TeaTimeIroh/AutomatedChessboard/docs/images/board_surface-detail_20260425_212329.jpg

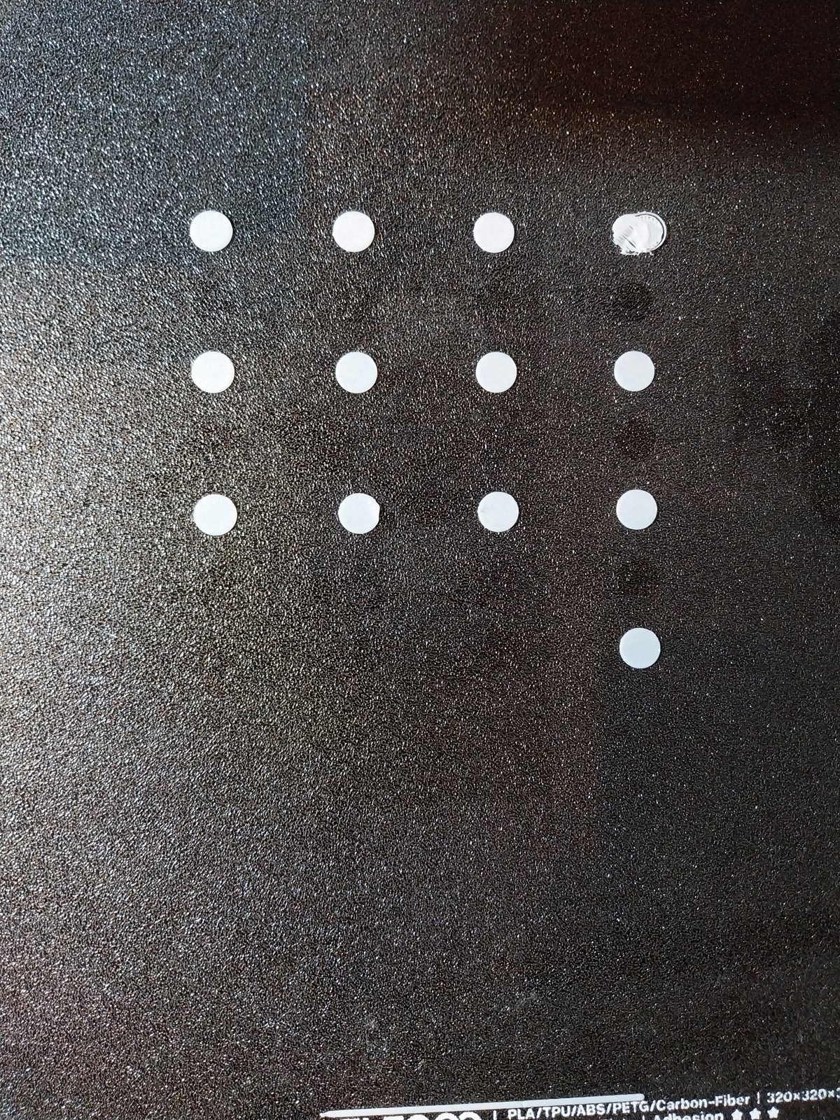
docs/images/board_surface-detail_20260425_212329.jpg
