TeaTimeIroh/AutomatedChessboard/docs/images/board_surface_20260415_192006.jpg

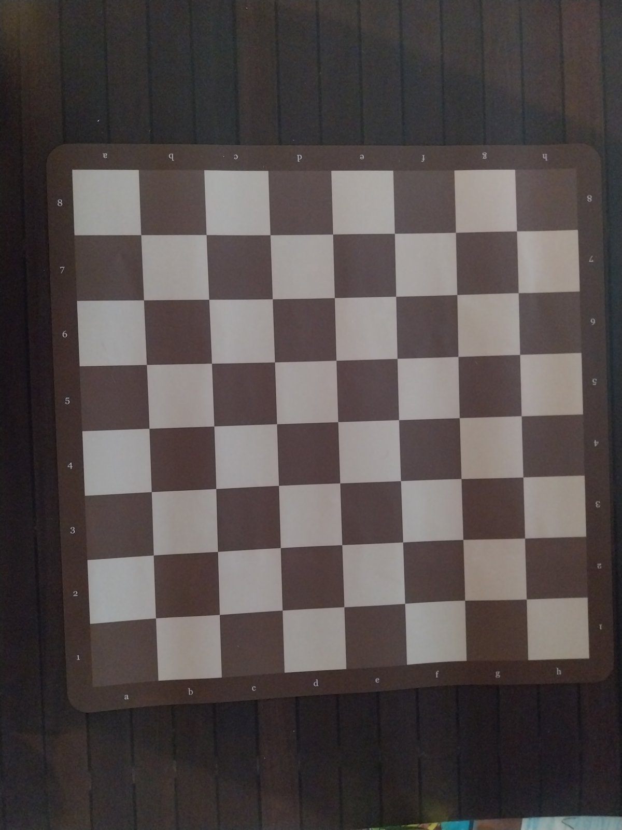
docs/images/board_surface_20260415_192006.jpg
