TeaTimeIroh/AutomatedChessboard/docs/images/corexy_stepper-mount-detail_20260308_001144.jpg

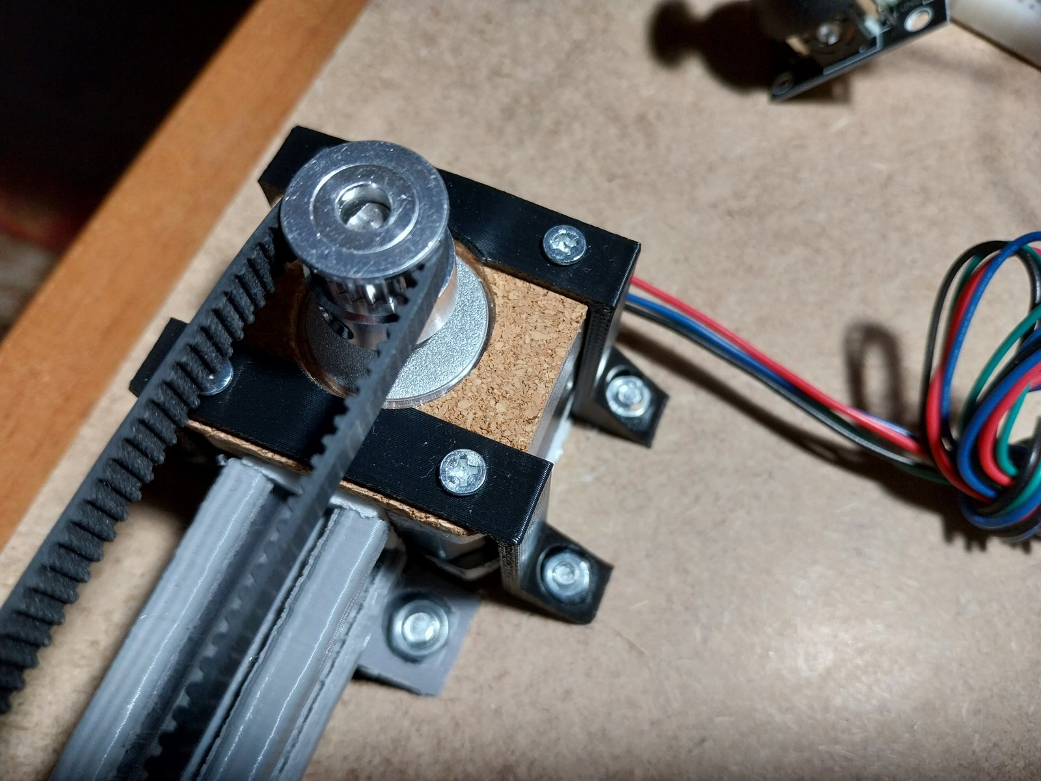
docs/images/corexy_stepper-mount-detail_20260308_001144.jpg
