TeaTimeIroh/AutomatedChessboard/docs/images/final_gantry-underside_20260501_181351.jpg

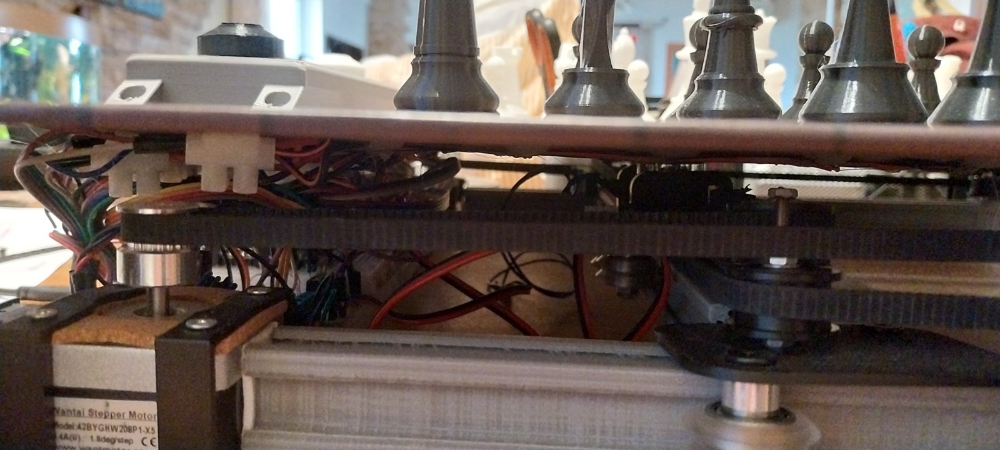
docs/images/final_gantry-underside_20260501_181351.jpg
