TeaTimeIroh/AutomatedChessboard/docs/images/final_ui-lcd-and-buttons_20260430_023114.jpg

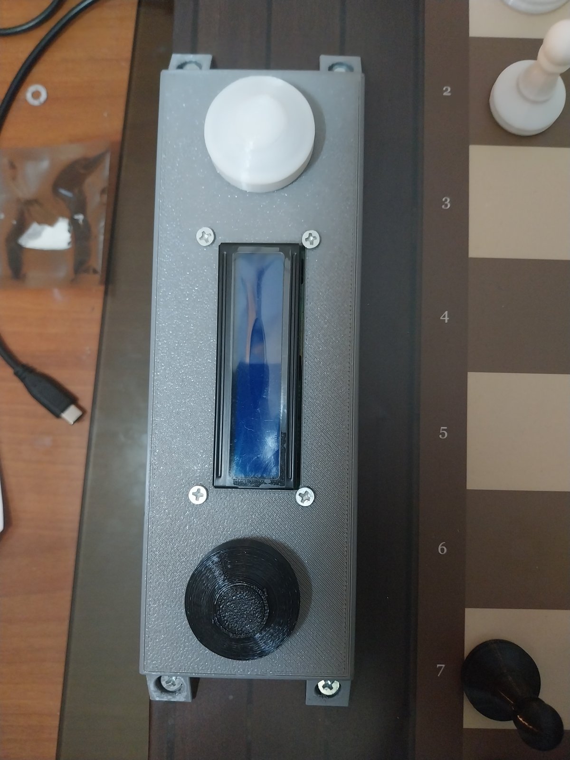
docs/images/final_ui-lcd-and-buttons_20260430_023114.jpg
