TeaTimeIroh/AutomatedChessboard/docs/images/reed-grid_copper-tape_20260313_010757.jpg

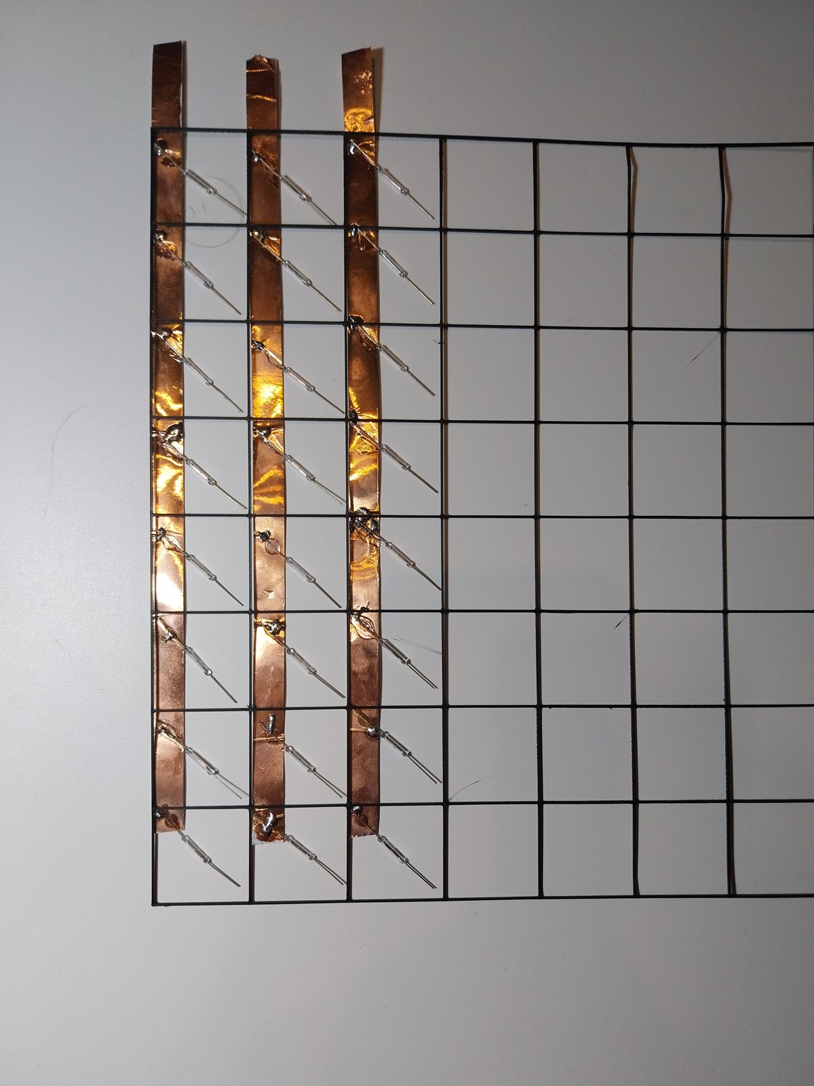
docs/images/reed-grid_copper-tape_20260313_010757.jpg
