TeaTimeIroh/AutomatedChessboard/docs/images/reed-grid_copper-tape_20260314_181305.jpg

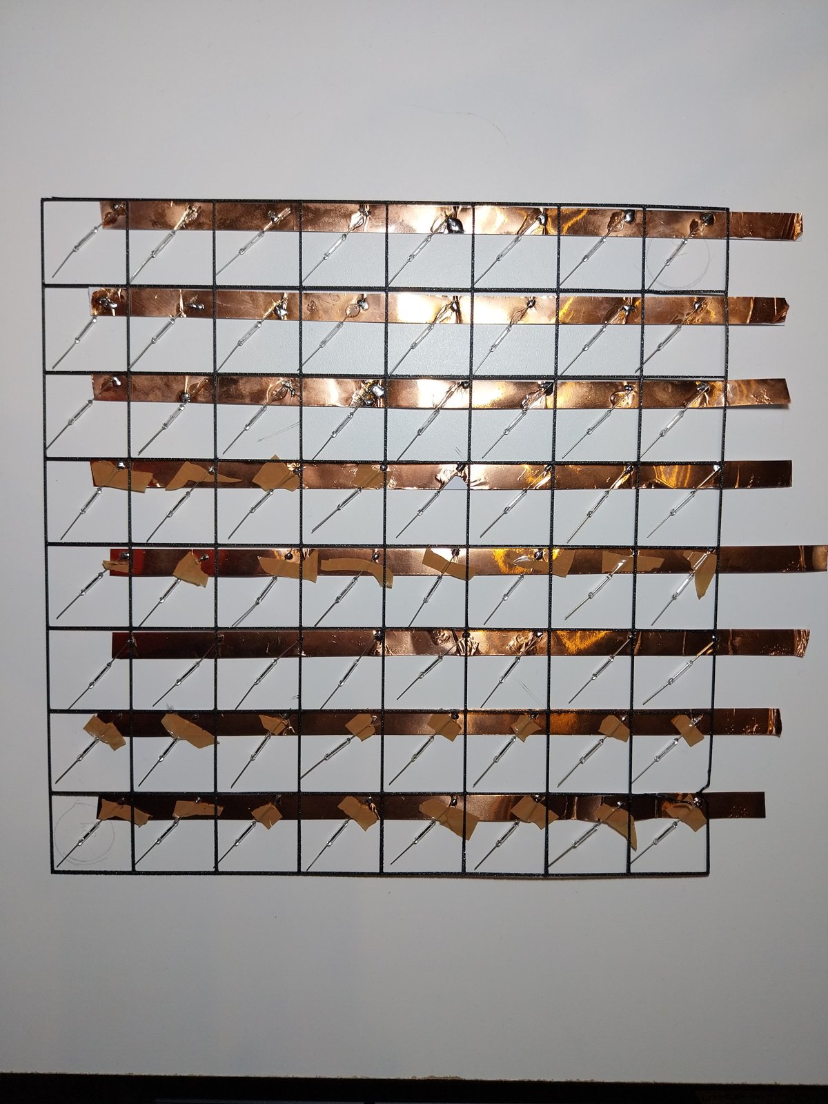
docs/images/reed-grid_copper-tape_20260314_181305.jpg
