TeaTimeIroh/AutomatedChessboard/Flowcharts/detectMove().png

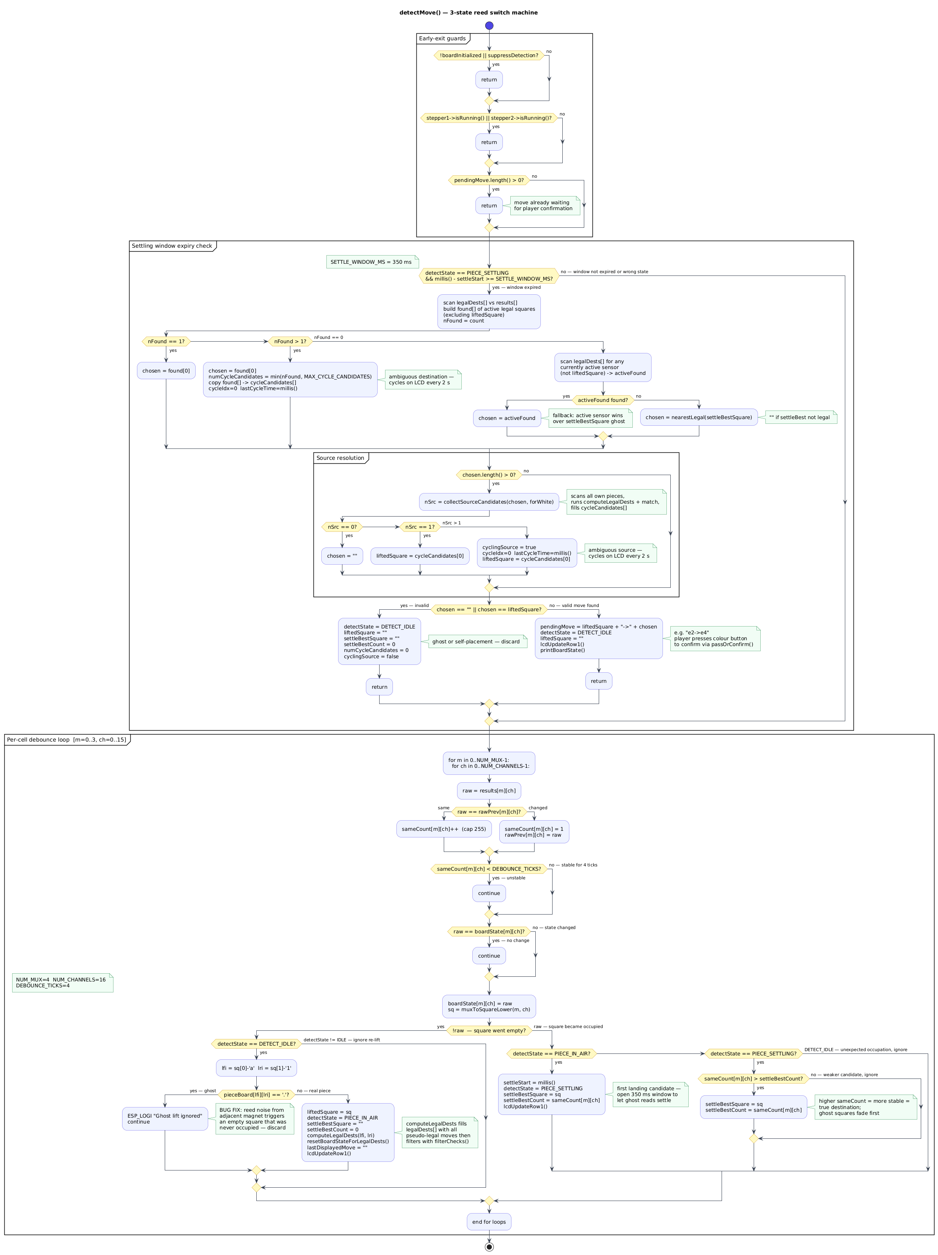
Flowcharts/detectMove().png
