TeaTimeIroh/AutomatedChessboard/Flowcharts/loop().png

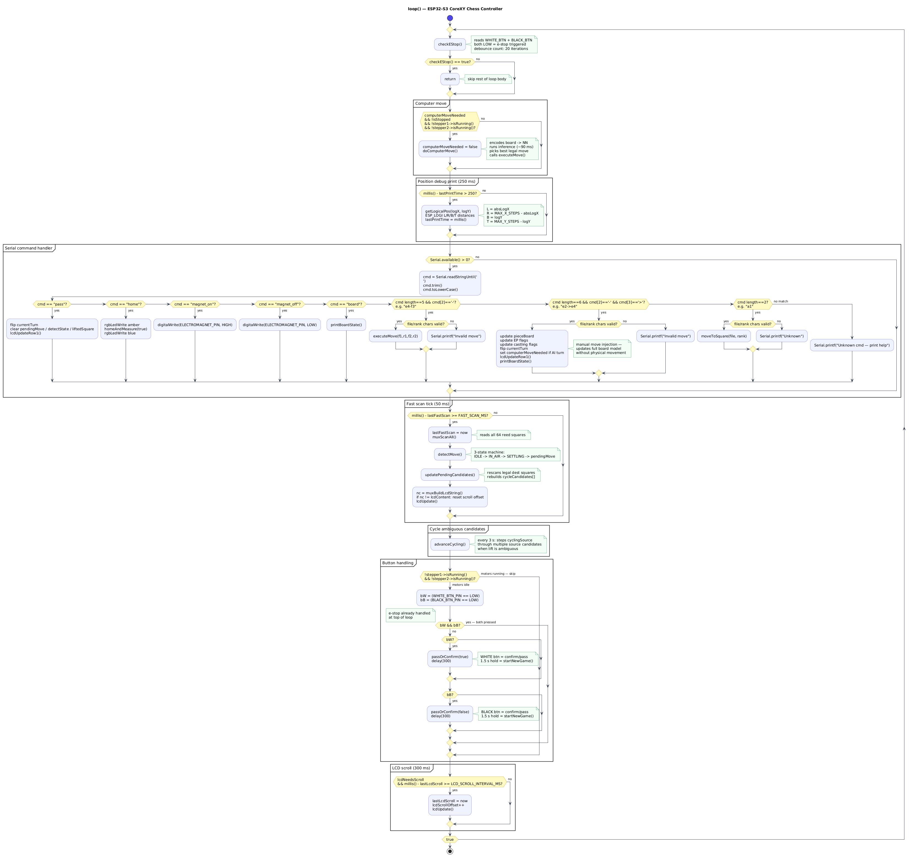
Flowcharts/loop().png
