TeaTimeIroh/AutomatedChessboard/Images/20260319_215423.jpg

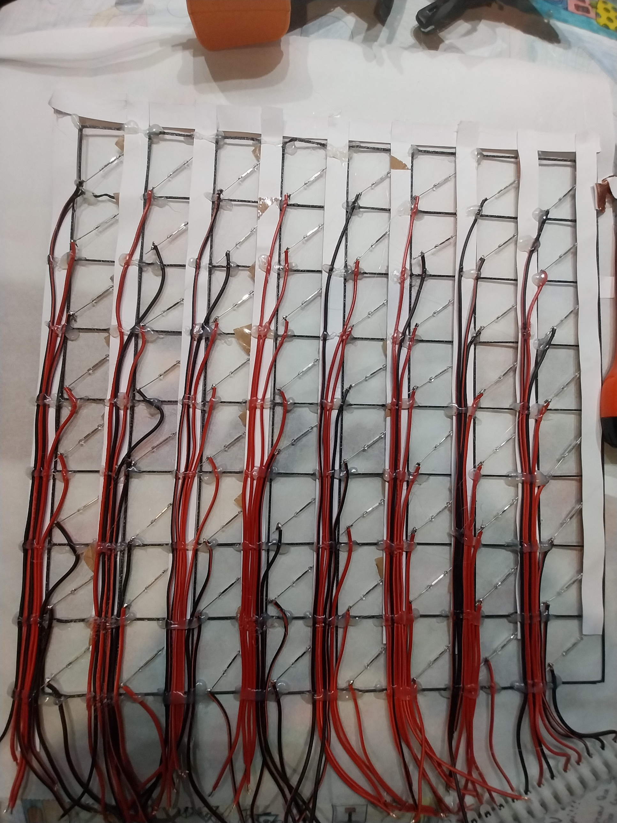
Images/20260319_215423.jpg
