TeaTimeIroh/AutomatedChessboard/Images/20260404_231630.jpg

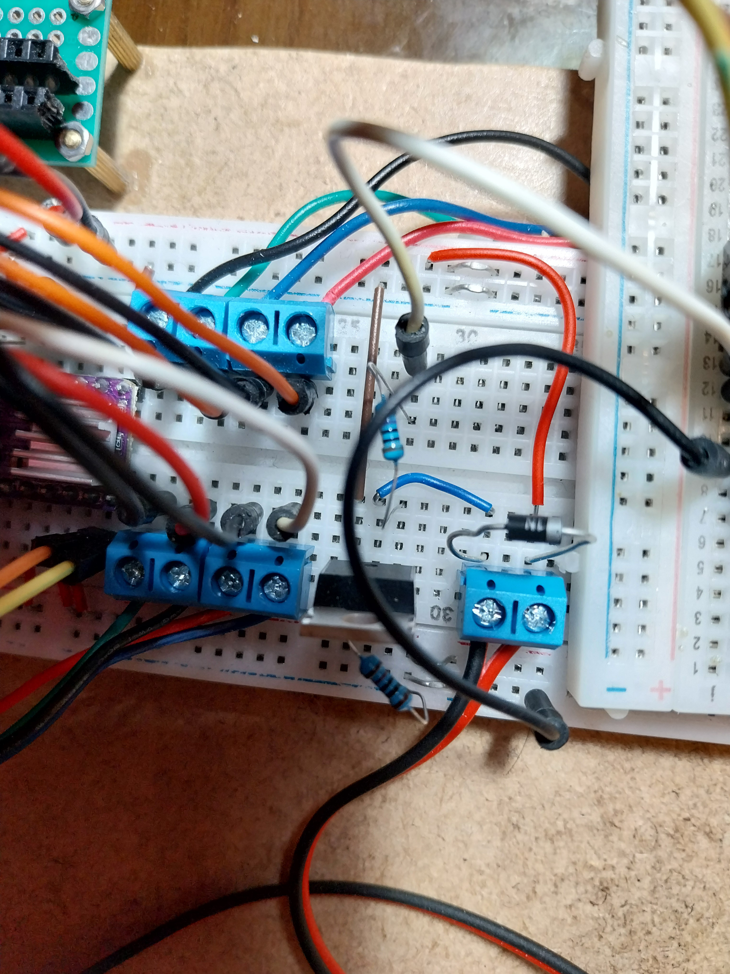
Images/20260404_231630.jpg
