TeaTimeIroh/AutomatedChessboard/3D Models/VbeamFullLengthBase.stl

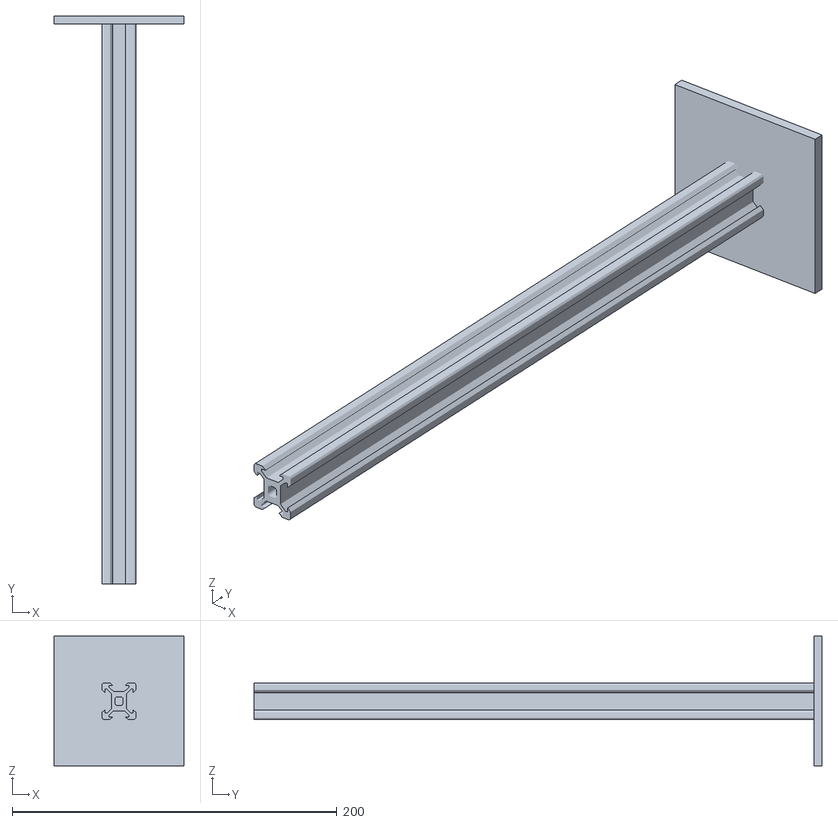
[picture p93: CAD file, 2026-05-11]
3D Models/VbeamFullLengthBase.stl
80.0 x 350.0 x 80.0
