TeaTimeIroh/AutomatedChessboard/3D Models/ButtonLarge.stl

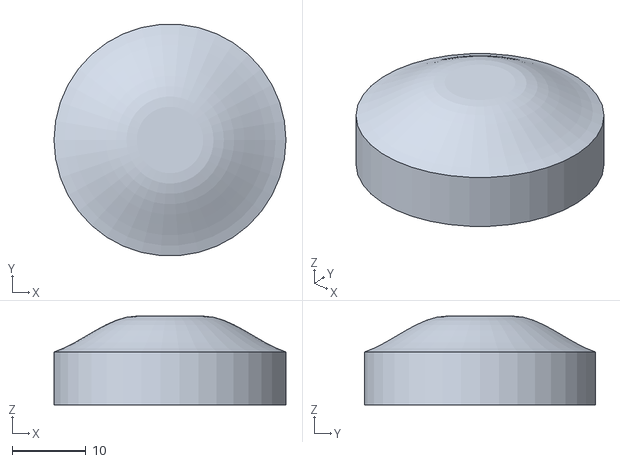
[picture p94: CAD file, 2026-05-11]
3D Models/ButtonLarge.stl
31.4 x 31.3 x 12.0
