TeaTimeIroh/AutomatedChessboard/cad/parts/LittleCircleExtension.stl

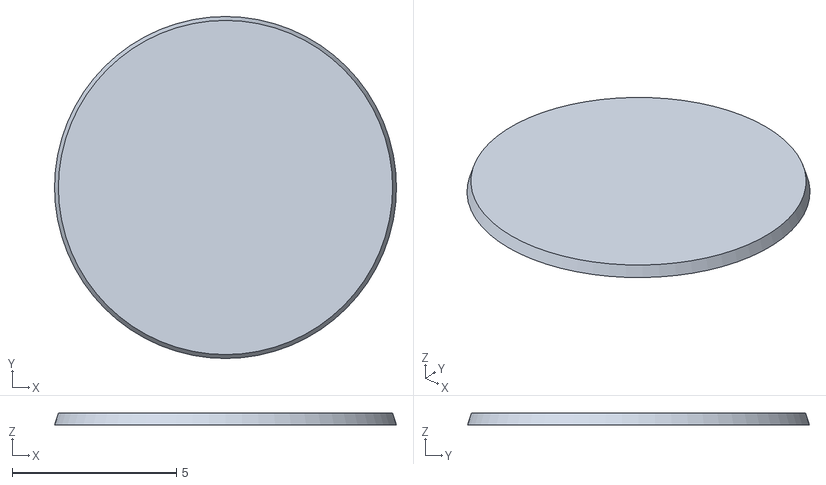
[picture p95: CAD file, 2026-05-11]
cad/parts/LittleCircleExtension.stl
10.4 x 10.4 x 0.37
