TeaTimeIroh/AutomatedChessboard/cad/pieces/Knight.stl

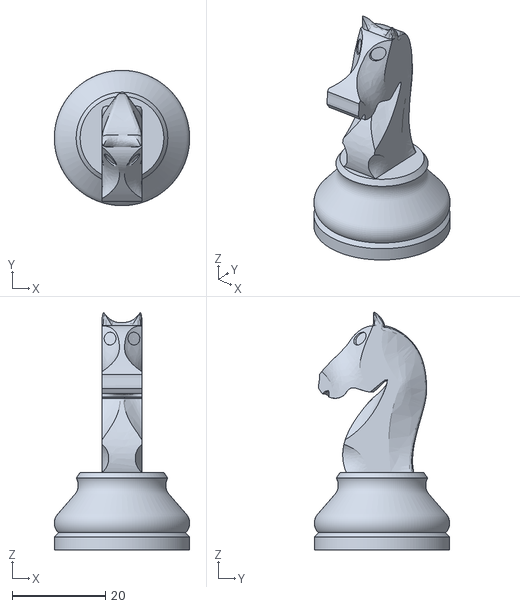
[picture p96: CAD file, 2026-05-11]
cad/pieces/Knight.stl
29.0 x 29.0 x 51.0
