TeaTimeIroh/AutomatedChessboard/3D Models/SideTrolleyDiagonalWheels.stl

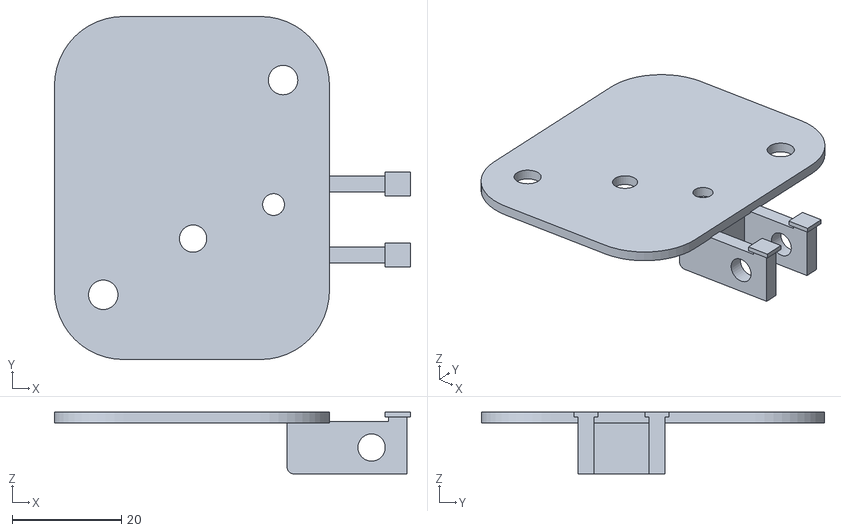
[picture p97: CAD file, 2026-05-11]
3D Models/SideTrolleyDiagonalWheels.stl
65.3 x 62.9 x 11.4
