TeaTimeIroh/AutomatedChessboard/cad/parts/lcdandbuttons.stl

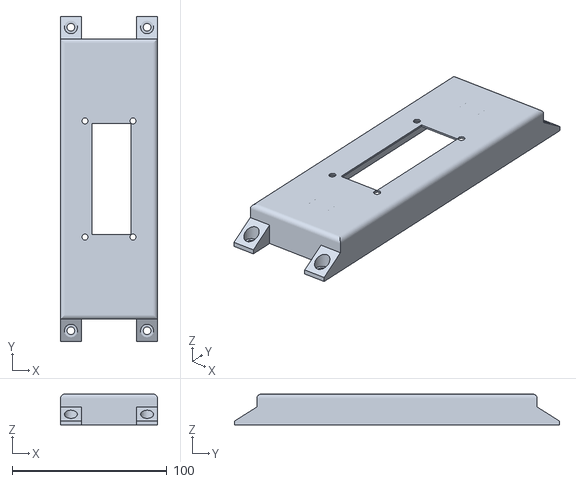
[picture p98: CAD file, 2026-05-11]
cad/parts/lcdandbuttons.stl
62.6 x 209.7 x 20.0
