TeaTimeIroh/AutomatedChessboard/cad/pieces/PawnChessNoCollisions.stl

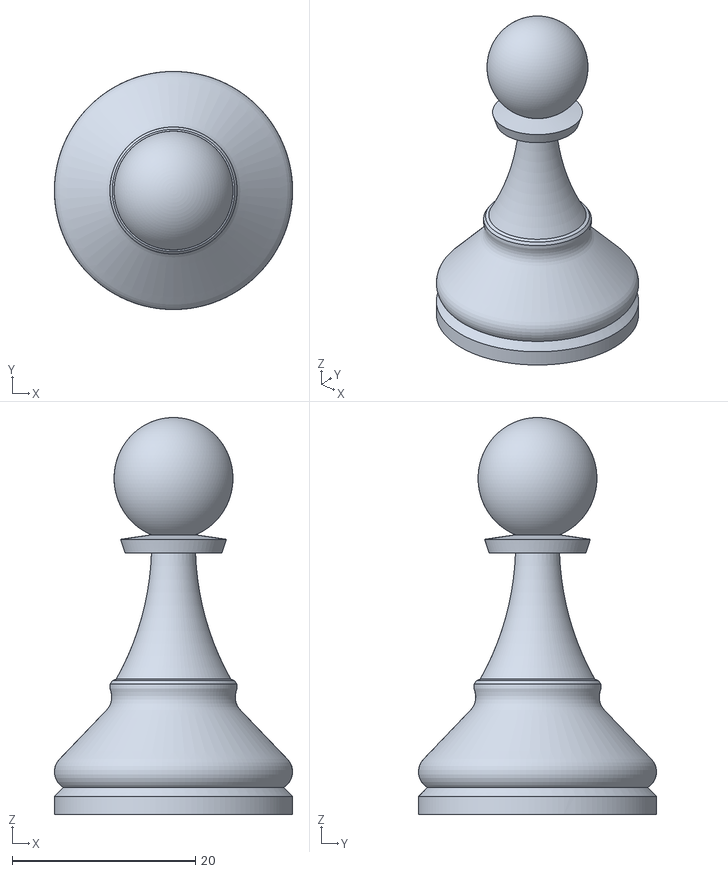
[picture p99: CAD file, 2026-05-11]
cad/pieces/PawnChessNoCollisions.stl
26.0 x 26.0 x 43.3
