TeaTimeIroh/AutomatedChessboard/3D Models/LShapedCornerBeamForWalls_10cmWide.stl

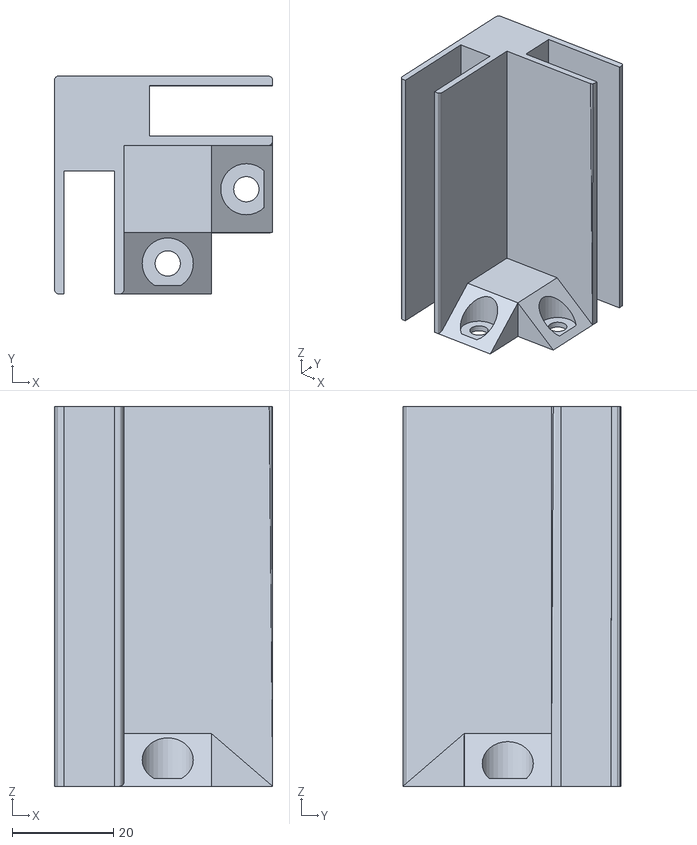
[picture p100: CAD file, 2026-05-11]
3D Models/LShapedCornerBeamForWalls_10cmWide.stl
43.1 x 43.1 x 75.0
