TeaTimeIroh/AutomatedChessboard/cad/parts/SideTrolleySwitchAutomaticChesboard.stl

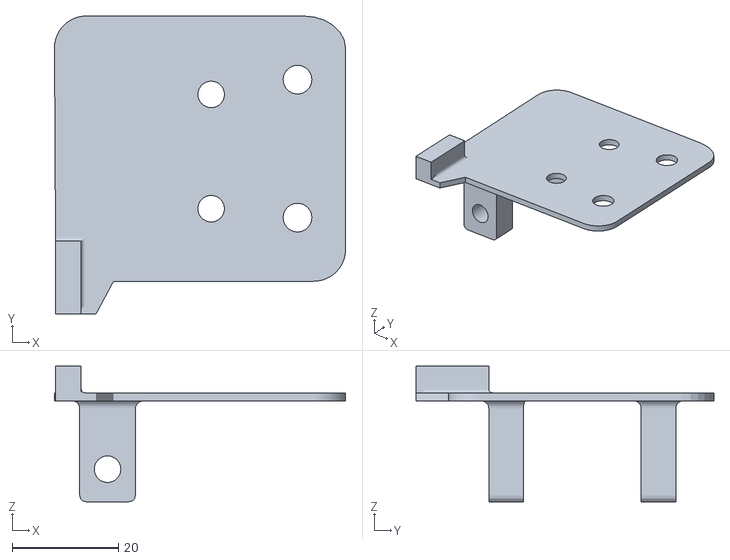
[picture p101: CAD file, 2026-05-11]
cad/parts/SideTrolleySwitchAutomaticChesboard.stl
54.9 x 56.2 x 25.5
