TeaTimeIroh/AutomatedChessboard/cad/pieces/Queen.stl

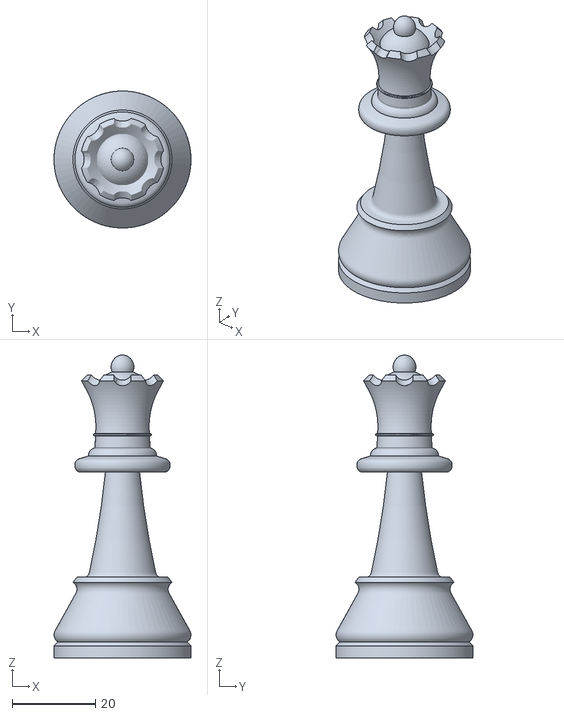
[picture p102: CAD file, 2026-05-11]
cad/pieces/Queen.stl
33.0 x 33.0 x 73.0
