TeaTimeIroh/AutomatedChessboard/3D Models/King.stl

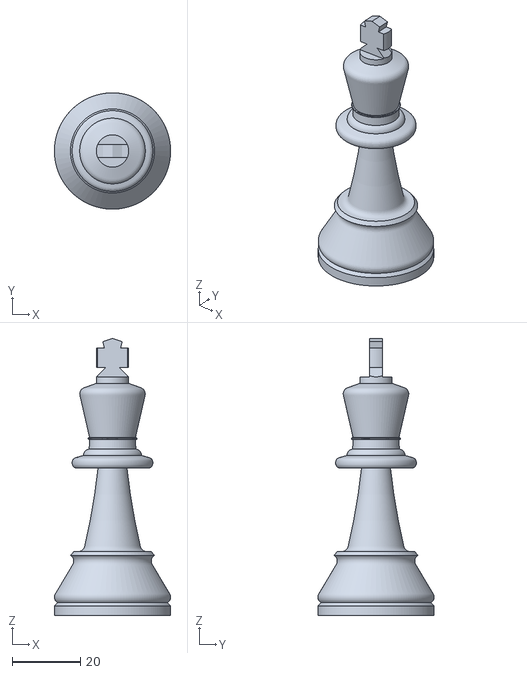
[picture p103: CAD file, 2026-05-11]
3D Models/King.stl
34.0 x 34.0 x 81.0
