TeaTimeIroh/AutomatedChessboard/cad/parts/SideTrolleyWithoutSwitchAutomaticChesboard.stl

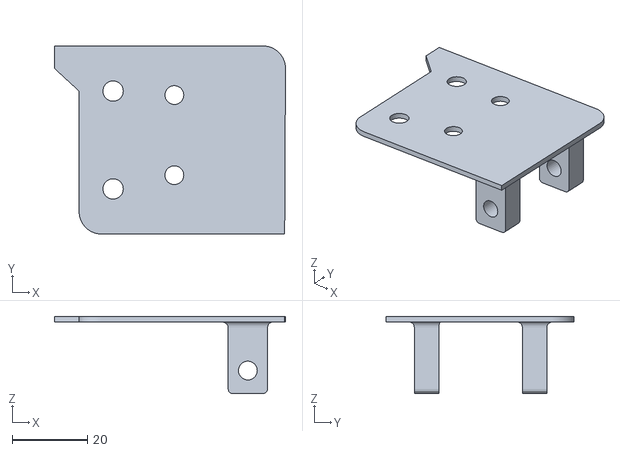
[picture p104: CAD file, 2026-05-11]
cad/parts/SideTrolleyWithoutSwitchAutomaticChesboard.stl
61.4 x 50.0 x 20.5
