TeaTimeIroh/AutomatedChessboard/3D Models/BoardHelper.stl

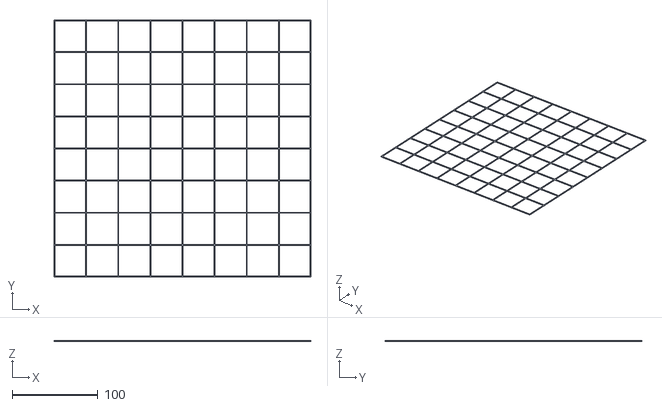
[picture p105: CAD file, 2026-05-11]
3D Models/BoardHelper.stl
300.0 x 300.0 x 1.00
