TeaTimeIroh/AutomatedChessboard/cad/parts/StepperMotorMount.stl

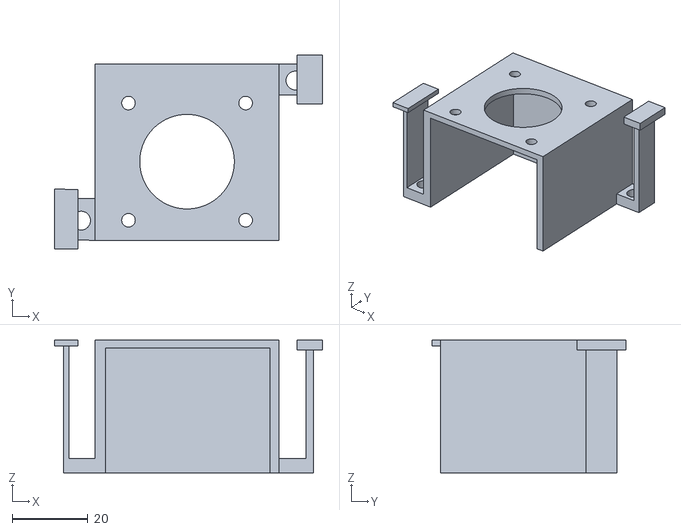
[picture p106: CAD file, 2026-05-11]
cad/parts/StepperMotorMount.stl
70.9 x 51.4 x 35.1
