TeaTimeIroh/AutomatedChessboard/3D Models/StraightSupport1cm.stl

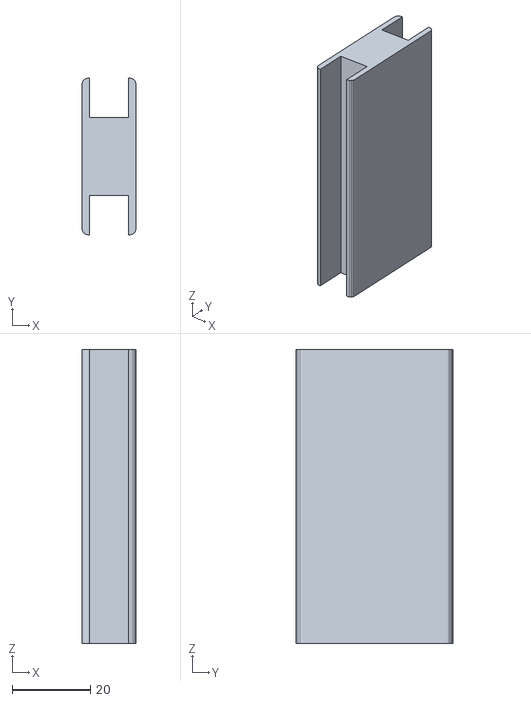
[picture p107: CAD file, 2026-05-11]
3D Models/StraightSupport1cm.stl
13.8 x 40.0 x 75.0
