TeaTimeIroh/AutomatedChessboard/cad/parts/StepperMotorMountPiShaped.stl

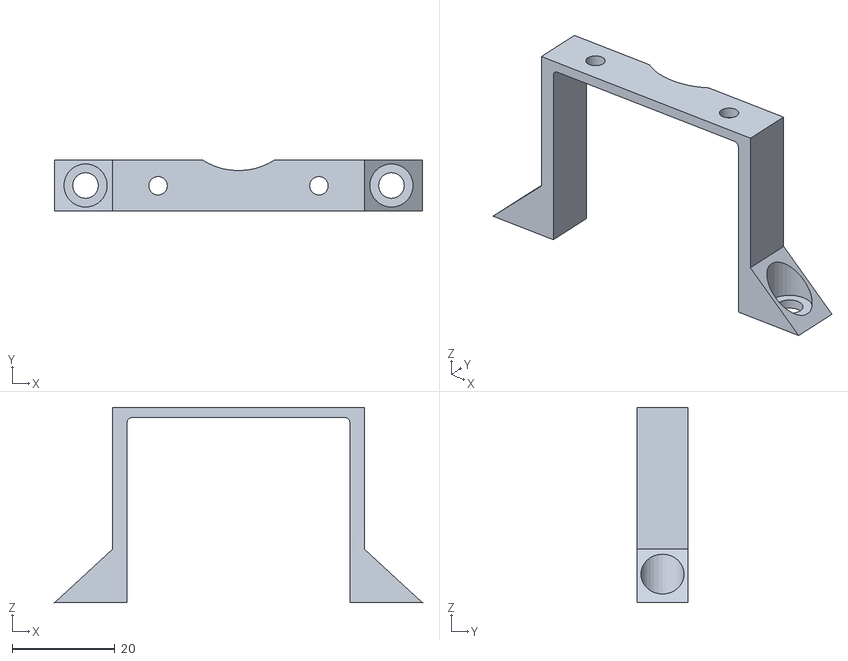
[picture p108: CAD file, 2026-05-11]
cad/parts/StepperMotorMountPiShaped.stl
71.7 x 10.0 x 38.1
