TeaTimeIroh/AutomatedChessboard/3D Models/electromagnetTrolley.stl

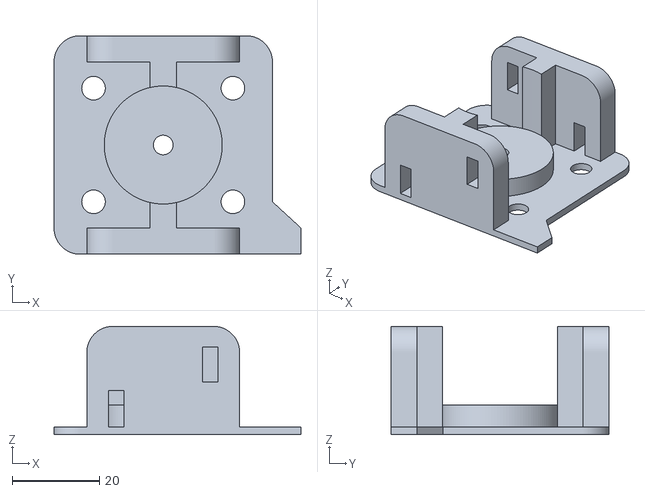
[picture p109: CAD file, 2026-05-11]
3D Models/electromagnetTrolley.stl
56.5 x 50.0 x 24.8
