TeaTimeIroh/AutomatedChessboard/cad/parts/StepperMotorMountLShapeFixed.stl

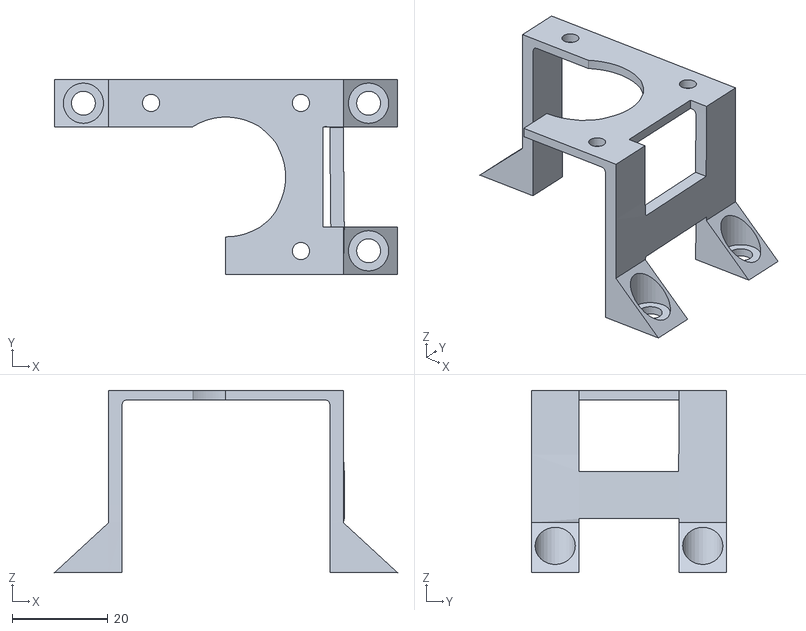
[picture p110: CAD file, 2026-05-11]
cad/parts/StepperMotorMountLShapeFixed.stl
71.7 x 40.8 x 38.1
