TeaTimeIroh/AutomatedChessboard/3D Models/Pawn.stl

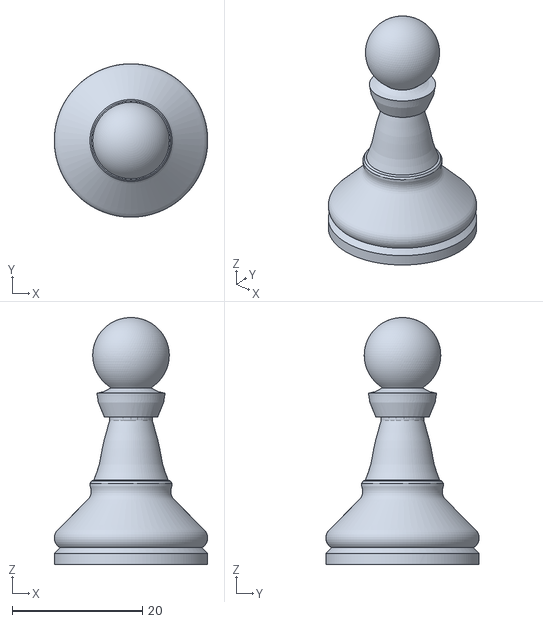
[picture p111: CAD file, 2026-05-11]
3D Models/Pawn.stl
23.6 x 23.6 x 38.0
