TeaTimeIroh/AutomatedChessboard/cad/parts/LShapedCornerBeam.stl

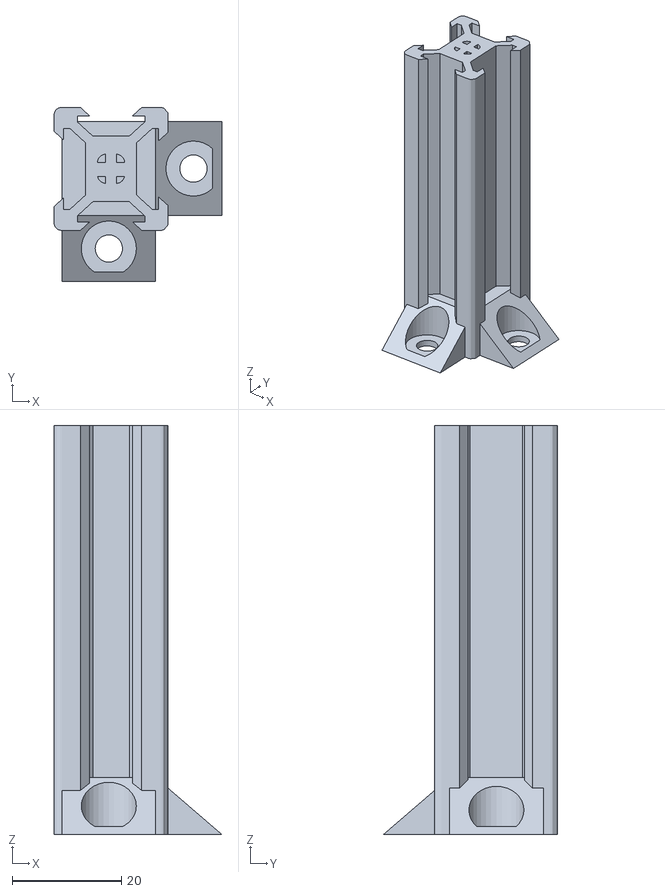
[picture p112: CAD file, 2026-05-11]
cad/parts/LShapedCornerBeam.stl
30.8 x 31.9 x 75.0
