TeaTimeIroh/AutomatedChessboard/3D Models/Rook.stl

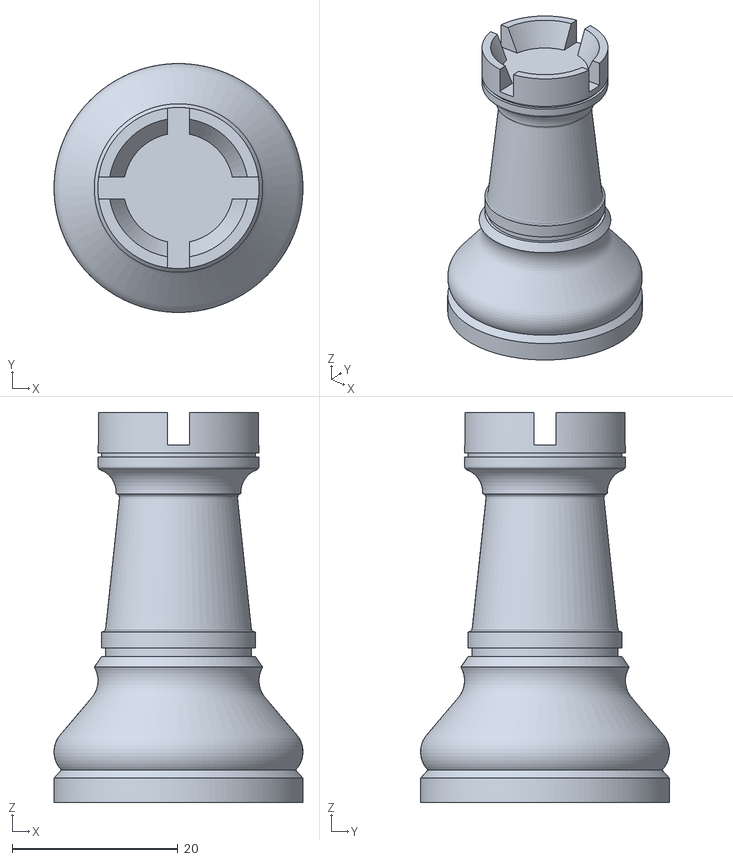
[picture p113: CAD file, 2026-05-11]
3D Models/Rook.stl
30.0 x 30.0 x 47.0
