TeaTimeIroh/AutomatedChessboard/3D Models/BlockerForSwitch.stl

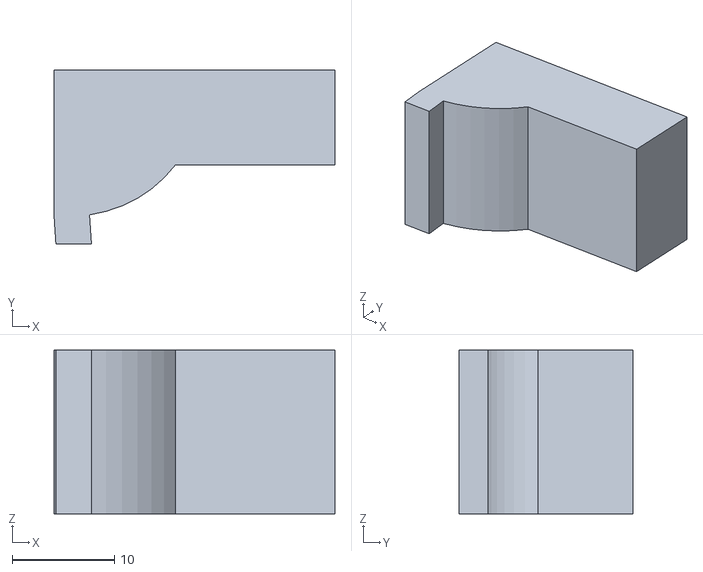
[picture p114: CAD file, 2026-05-11]
3D Models/BlockerForSwitch.stl
27.4 x 17.0 x 16.0
