TeaTimeIroh/AutomatedChessboard/3D Models/Bishop.stl

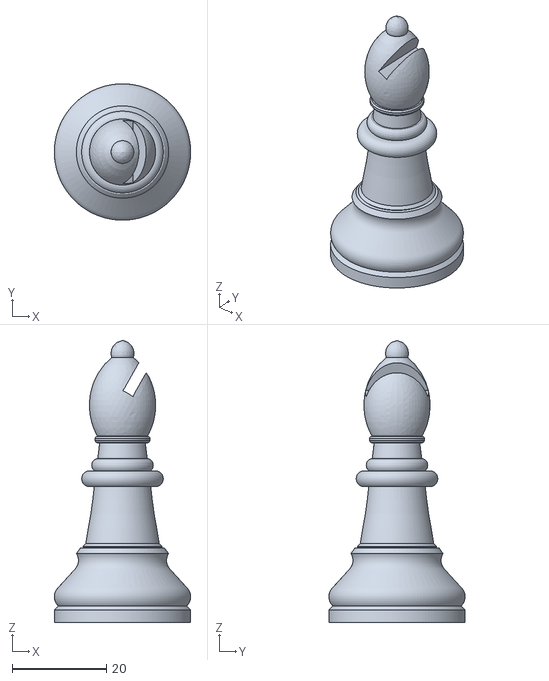
[picture p115: CAD file, 2026-05-11]
3D Models/Bishop.stl
29.0 x 29.0 x 60.0
