TeaTimeIroh/AutomatedChessboard/Neural Network/how to run the chess engine.txt

Anaconda prompt 

pip install pygame python-chess torch

conda activate pytorch_env
cd path
python play_chess.py
