TeaTimeIroh/AutomatedChessboard/docs/images/assembly_underside-wiring_20260405_002957.jpg

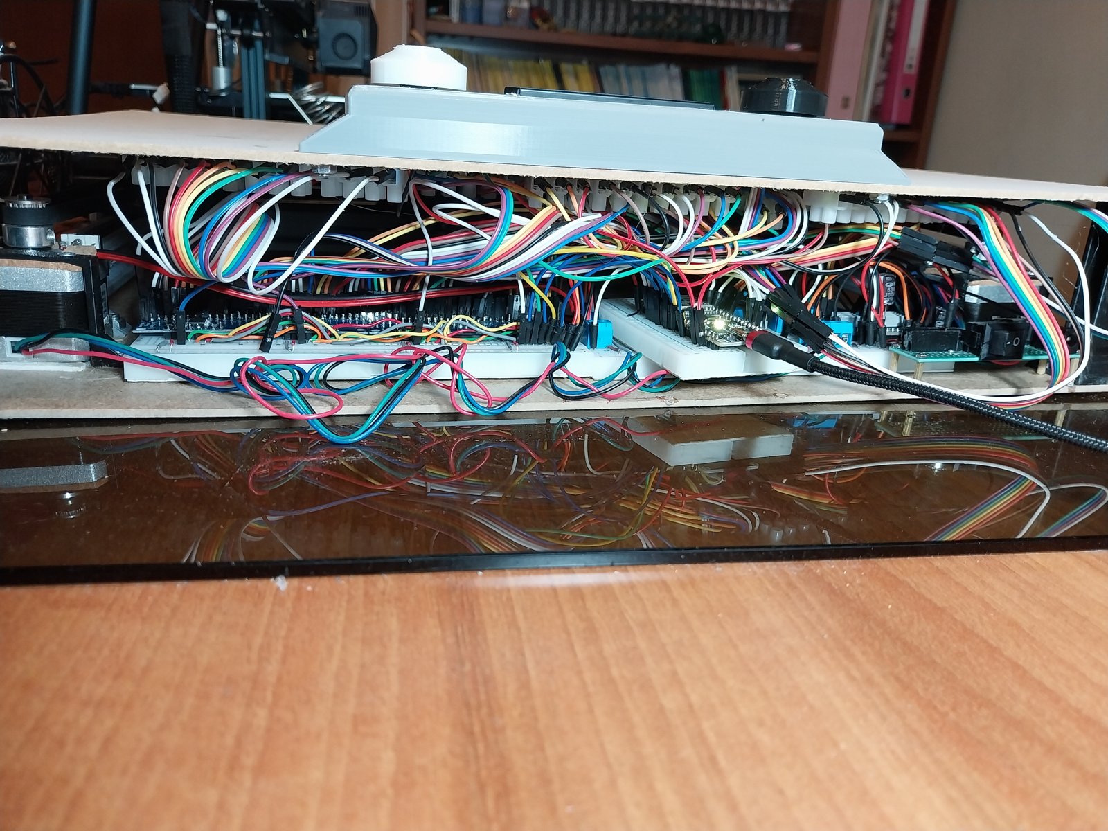
docs/images/assembly_underside-wiring_20260405_002957.jpg
