TeaTimeIroh/AutomatedChessboard/docs/images/assembly_underside-wiring_20260405_003001.jpg

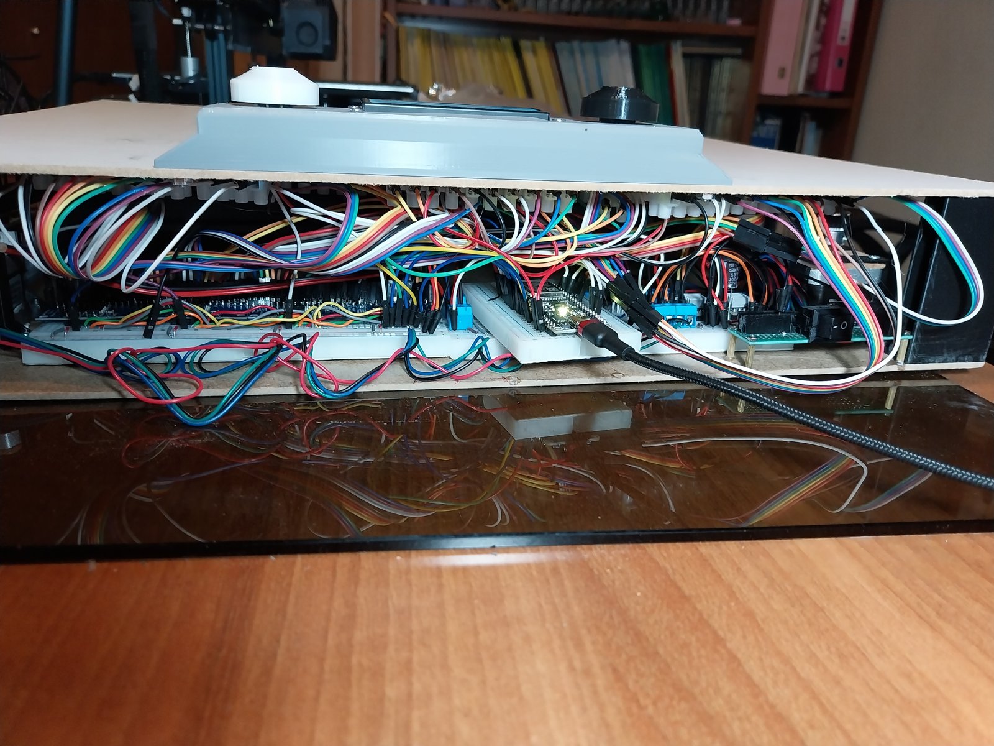
docs/images/assembly_underside-wiring_20260405_003001.jpg
