TeaTimeIroh/AutomatedChessboard/docs/images/corexy_frame-early-wiring_20260307_214317.jpg

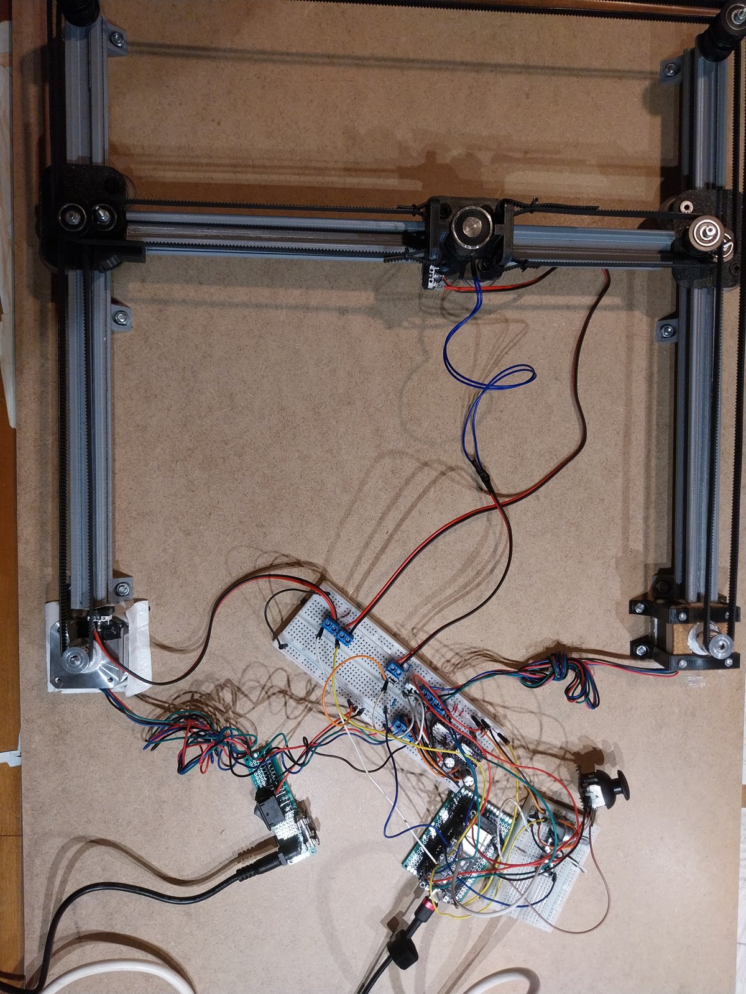
docs/images/corexy_frame-early-wiring_20260307_214317.jpg
