TeaTimeIroh/AutomatedChessboard/docs/images/electronics_wiring_20260404_231545.jpg

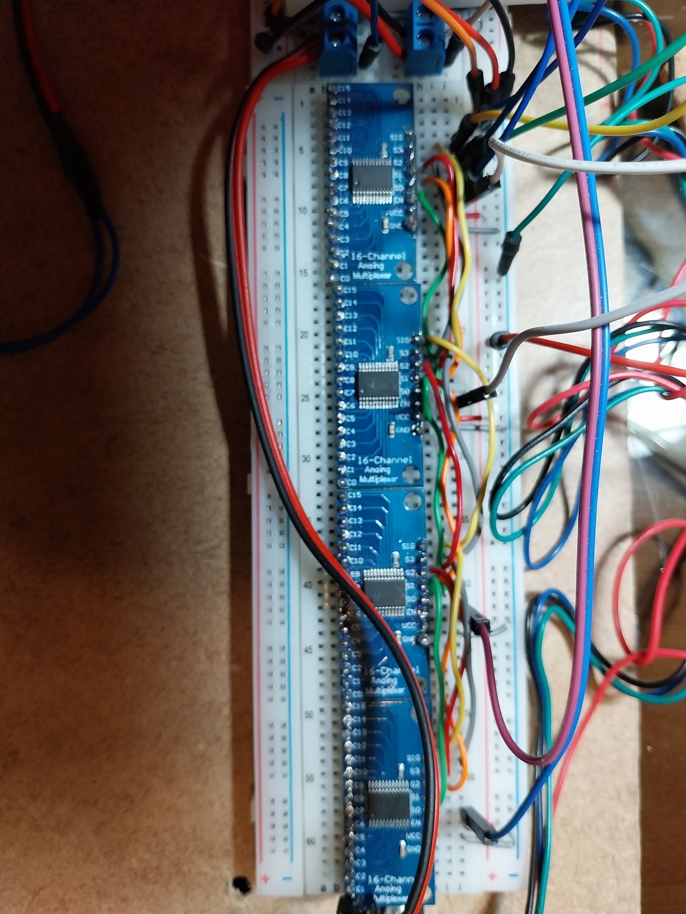
docs/images/electronics_wiring_20260404_231545.jpg
