TeaTimeIroh/AutomatedChessboard/docs/images/electronics_wiring_20260404_231604.jpg

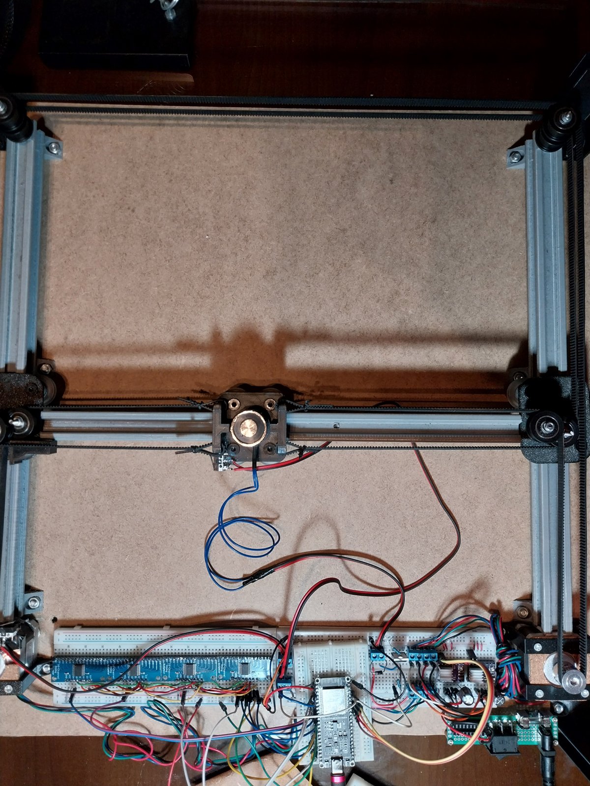
docs/images/electronics_wiring_20260404_231604.jpg
