TeaTimeIroh/AutomatedChessboard/docs/images/electronics_wiring_20260404_235357.jpg

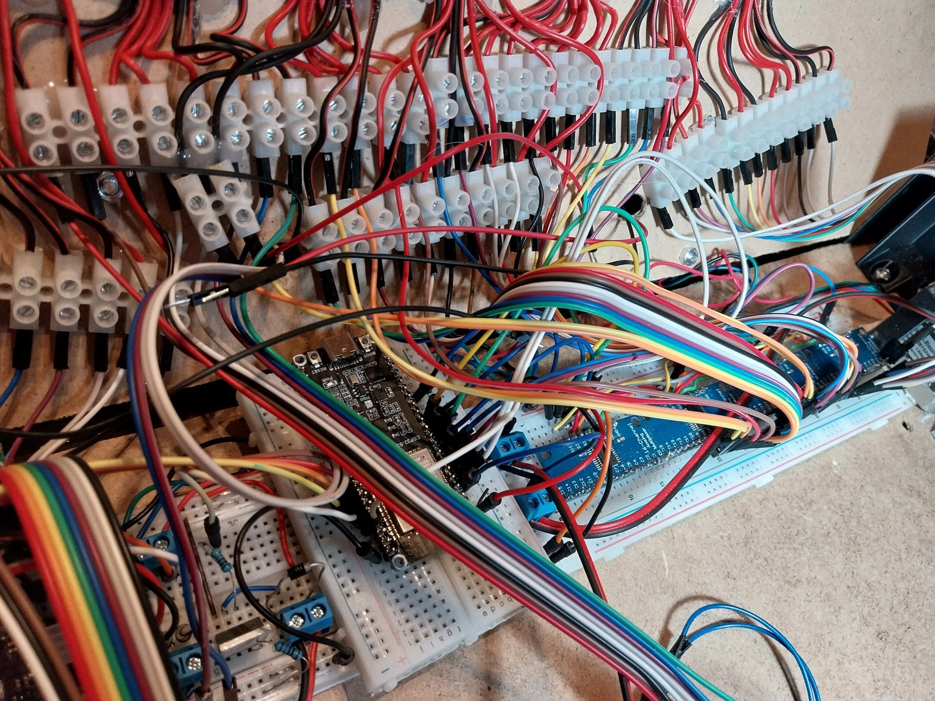
docs/images/electronics_wiring_20260404_235357.jpg
