TeaTimeIroh/AutomatedChessboard/docs/images/mux_wiring_20260324_225952.jpg

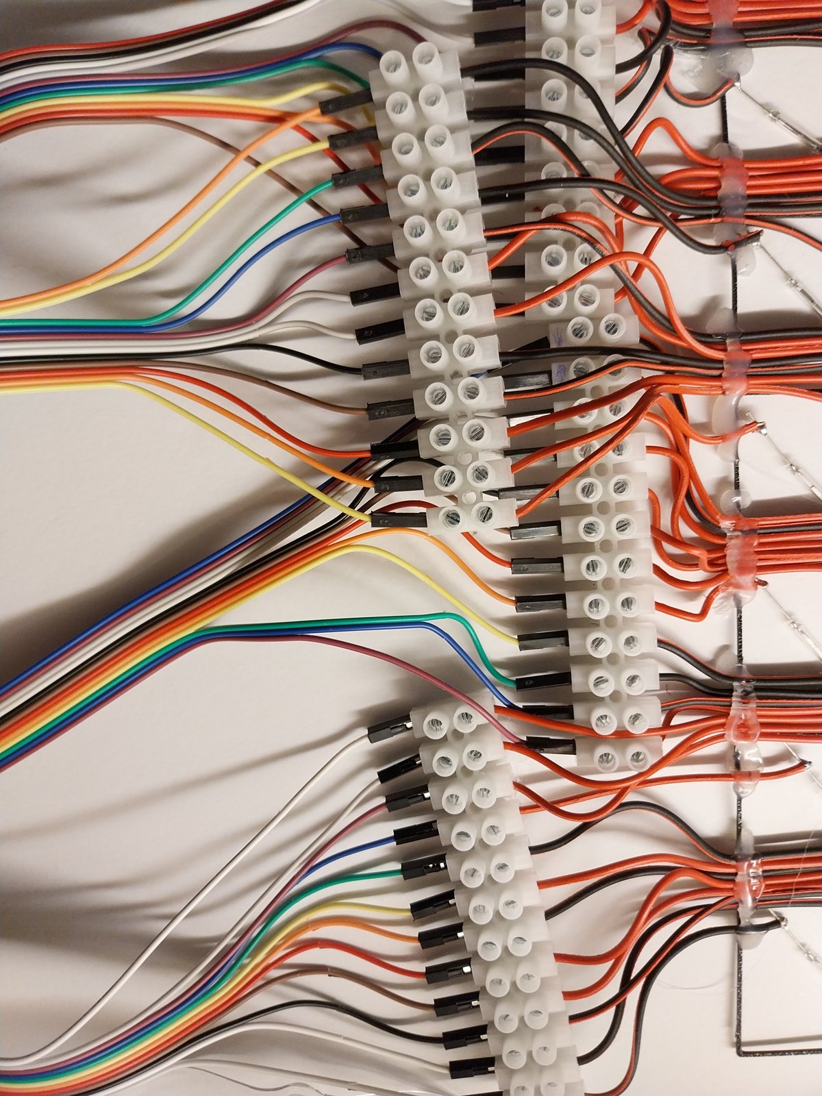
docs/images/mux_wiring_20260324_225952.jpg
