TeaTimeIroh/AutomatedChessboard/docs/images/mux_wiring_20260324_230011.jpg

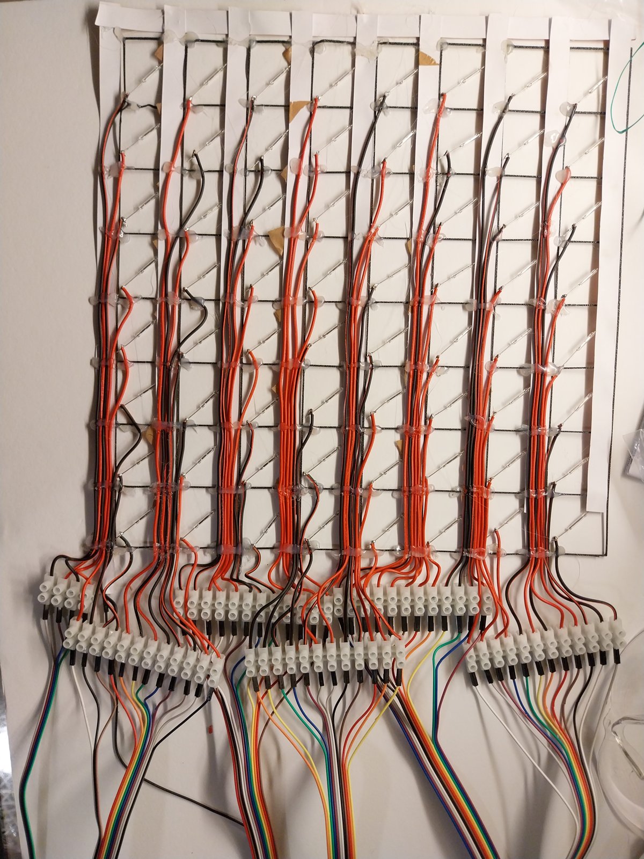
docs/images/mux_wiring_20260324_230011.jpg
