TeaTimeIroh/AutomatedChessboard/docs/images/pieces_print-test_20260228_175944.jpg

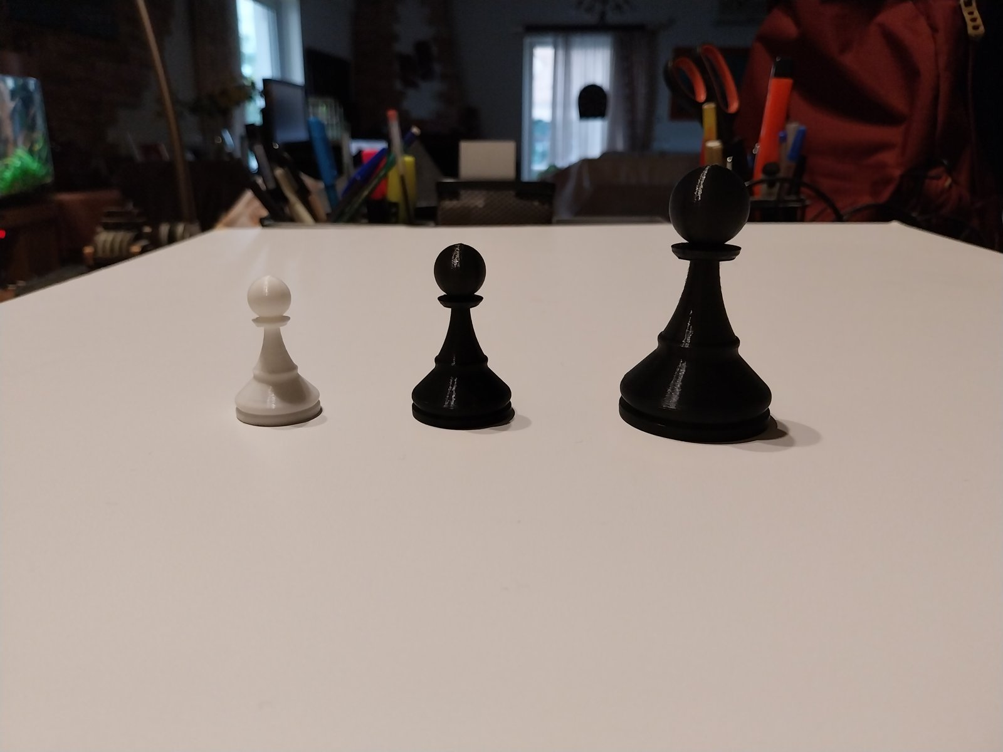
docs/images/pieces_print-test_20260228_175944.jpg
