TeaTimeIroh/AutomatedChessboard/docs/images/pieces_printed_20260425_212352.jpg

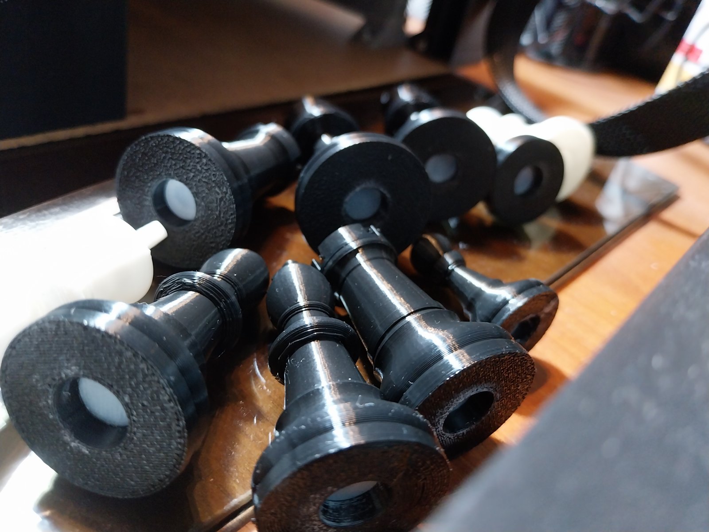
docs/images/pieces_printed_20260425_212352.jpg
