TeaTimeIroh/AutomatedChessboard/docs/images/reed-matrix_wiring_20260319_215346.jpg

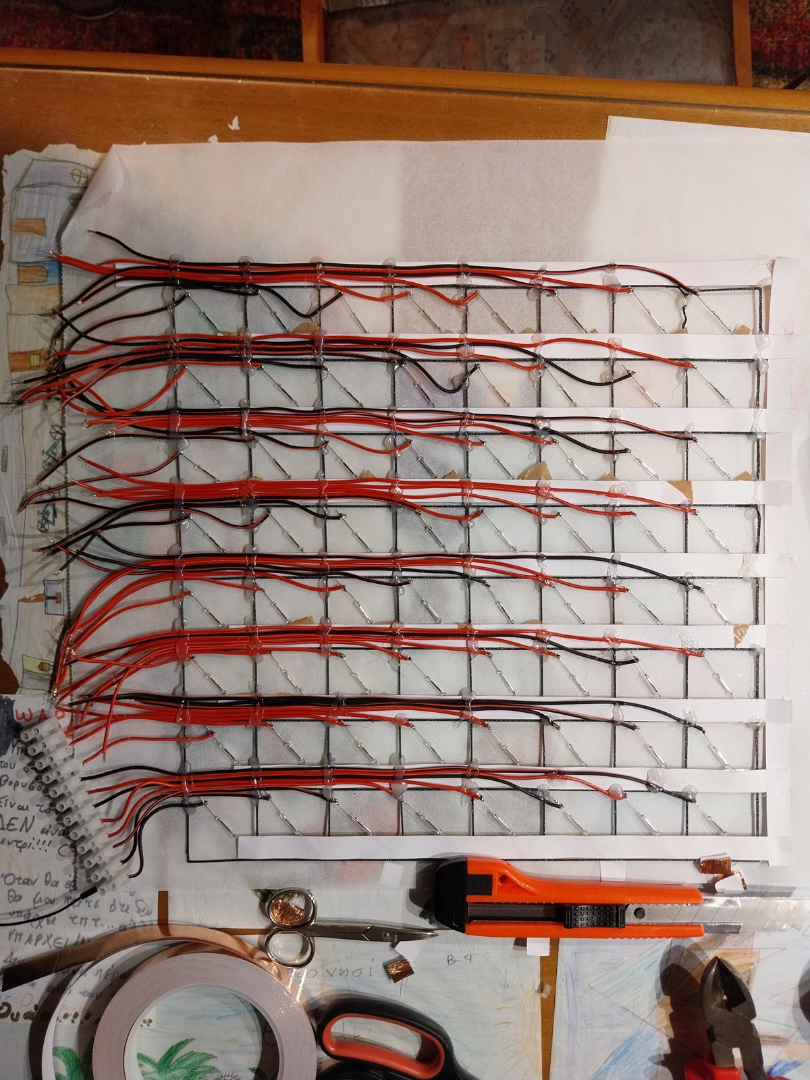
docs/images/reed-matrix_wiring_20260319_215346.jpg
