TeaTimeIroh/AutomatedChessboard/docs/images/reed-matrix_wiring_20260319_215354.jpg

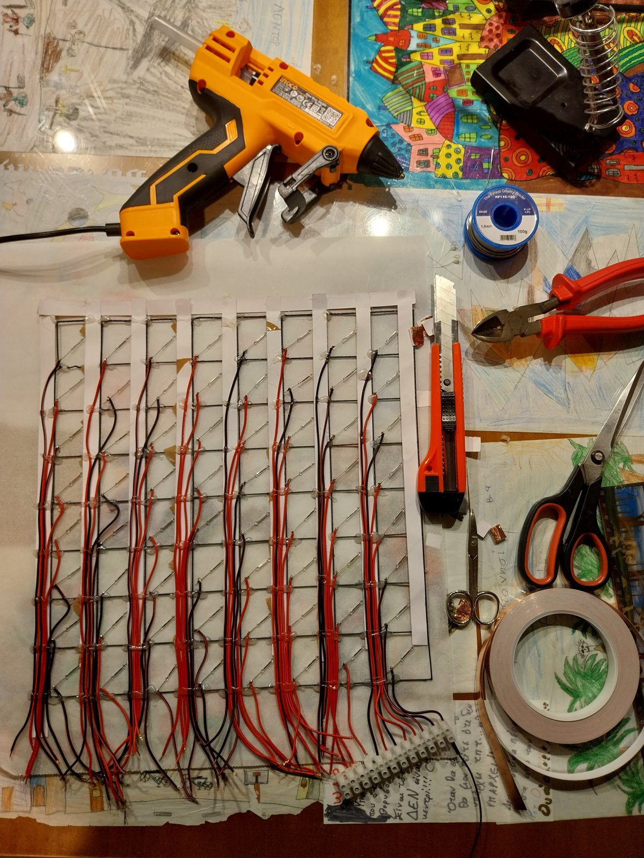
docs/images/reed-matrix_wiring_20260319_215354.jpg
