TeaTimeIroh/AutomatedChessboard/docs/images/reed-matrix_wiring_20260319_215402.jpg

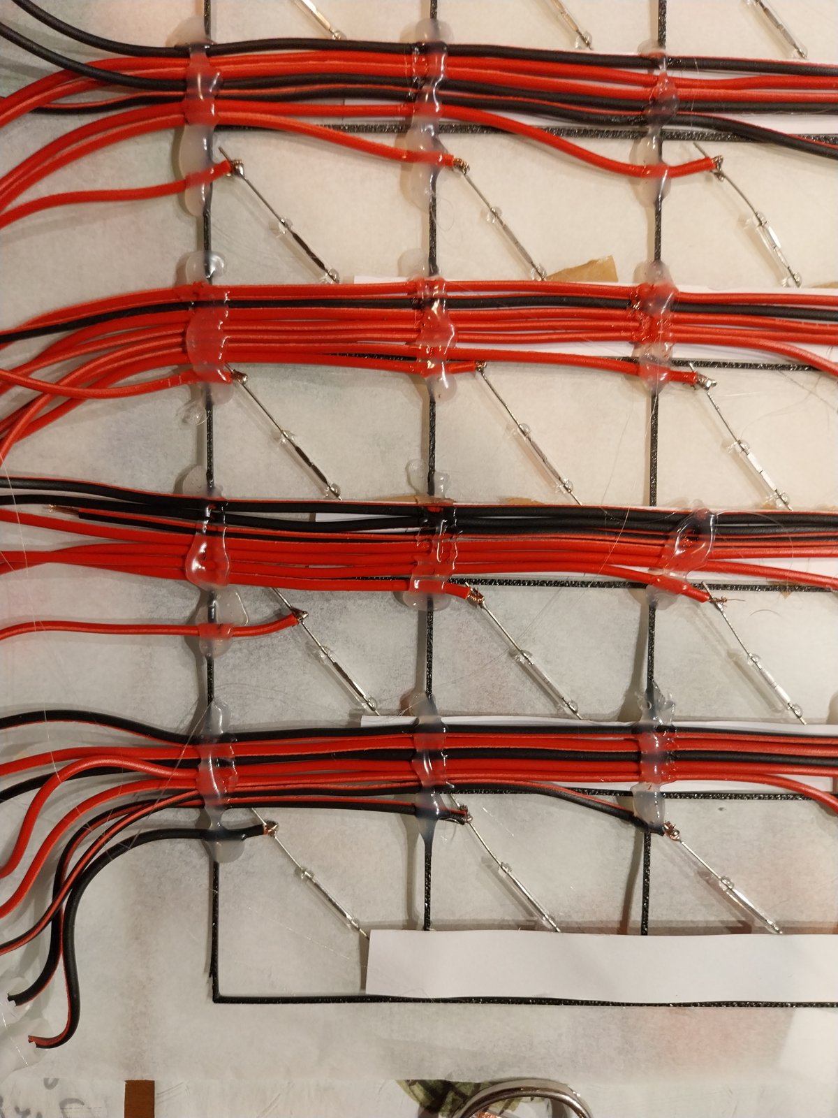
docs/images/reed-matrix_wiring_20260319_215402.jpg
