TeaTimeIroh/AutomatedChessboard/docs/images/reed-matrix_wiring_20260319_215413.jpg

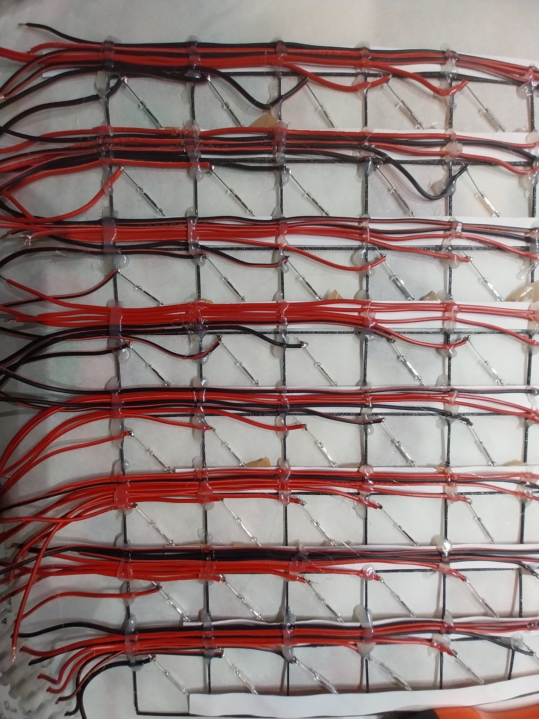
docs/images/reed-matrix_wiring_20260319_215413.jpg
