TeaTimeIroh/AutomatedChessboard/docs/images/reed-matrix_wiring_20260320_150208.jpg

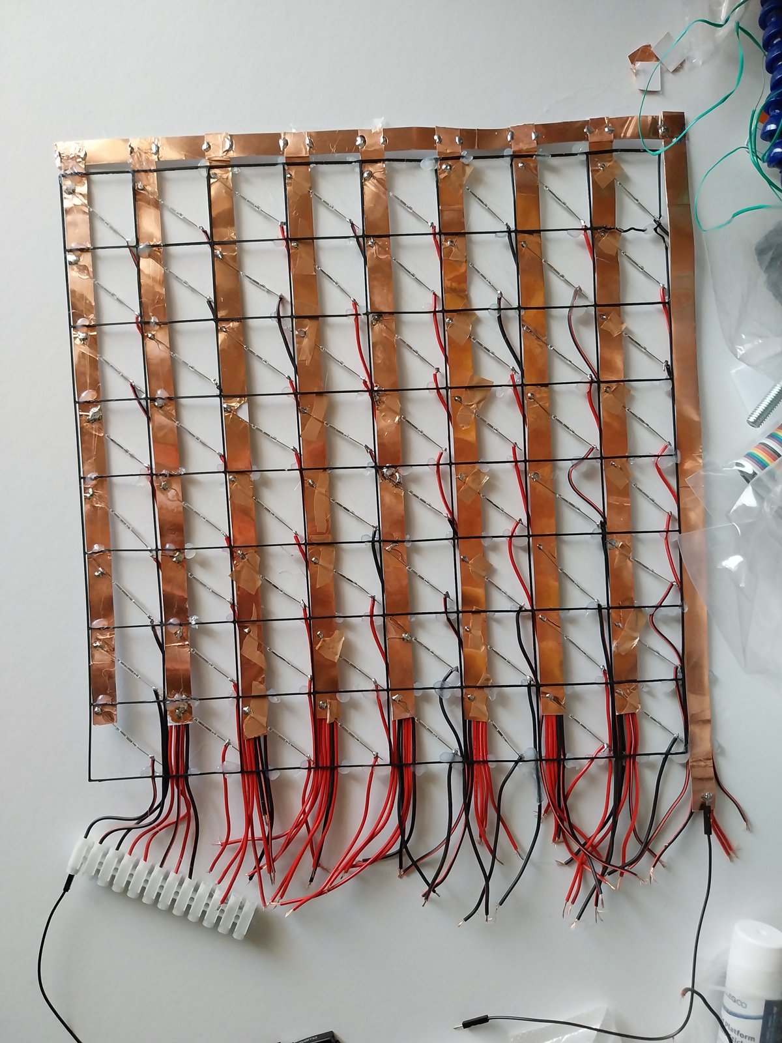
docs/images/reed-matrix_wiring_20260320_150208.jpg
