TeaTimeIroh/AutomatedChessboard/docs/images/reed-matrix_wiring_20260320_150229.jpg

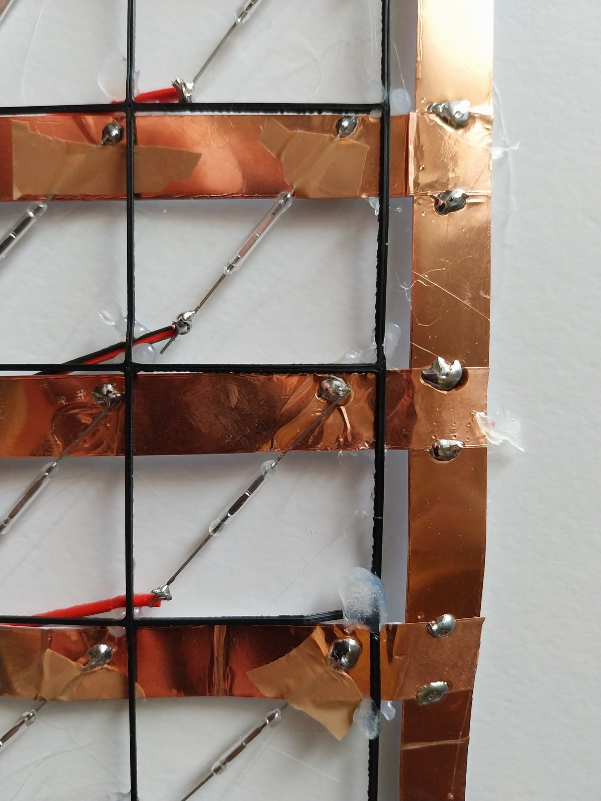
docs/images/reed-matrix_wiring_20260320_150229.jpg
