TeaTimeIroh/AutomatedChessboard/docs/images/ui-enclosure_print_20260328_205928.jpg

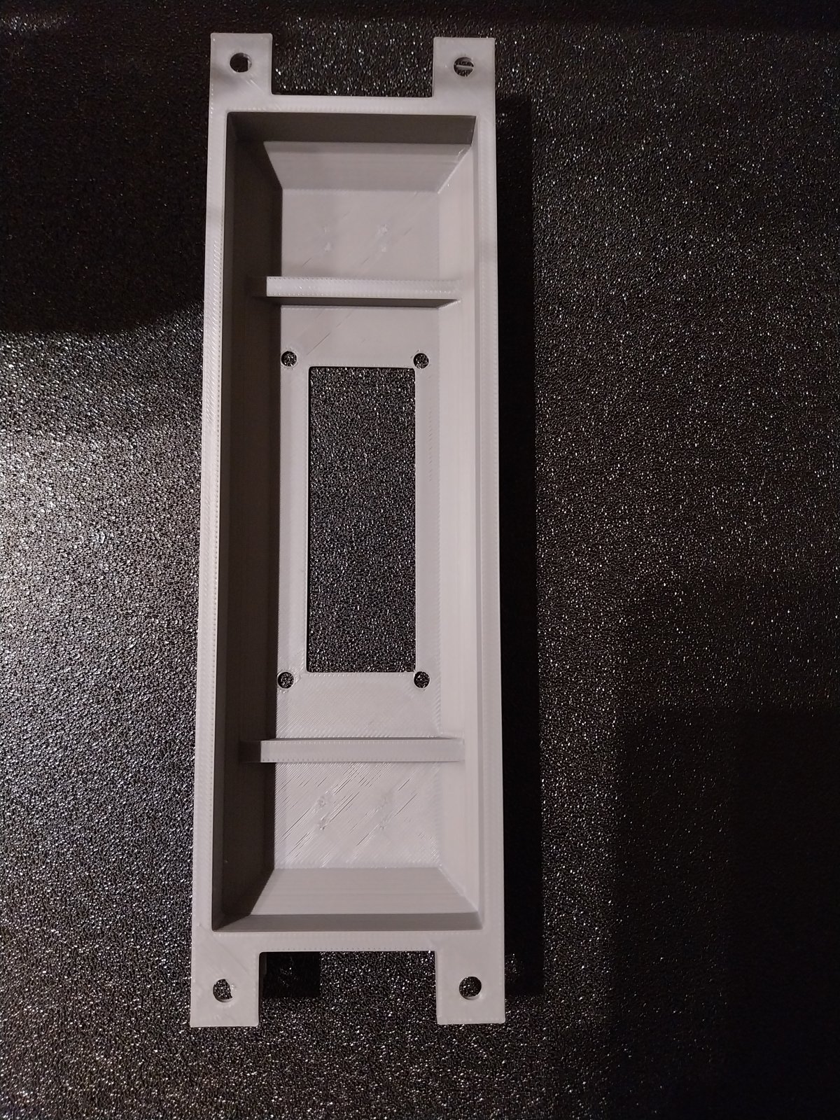
docs/images/ui-enclosure_print_20260328_205928.jpg
