TeaTimeIroh/AutomatedChessboard/docs/images/ui-enclosure_print_20260328_205938.jpg

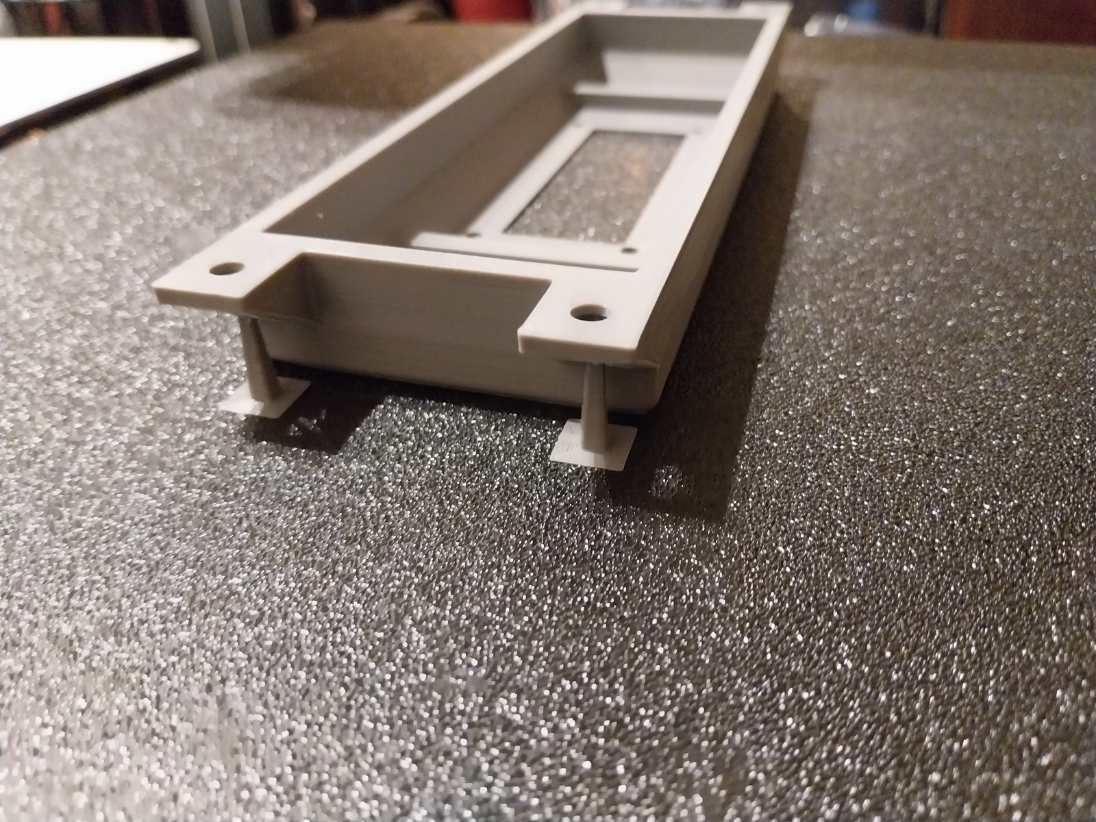
docs/images/ui-enclosure_print_20260328_205938.jpg
