TeaTimeIroh/AutomatedChessboard/Flowcharts/setup().png

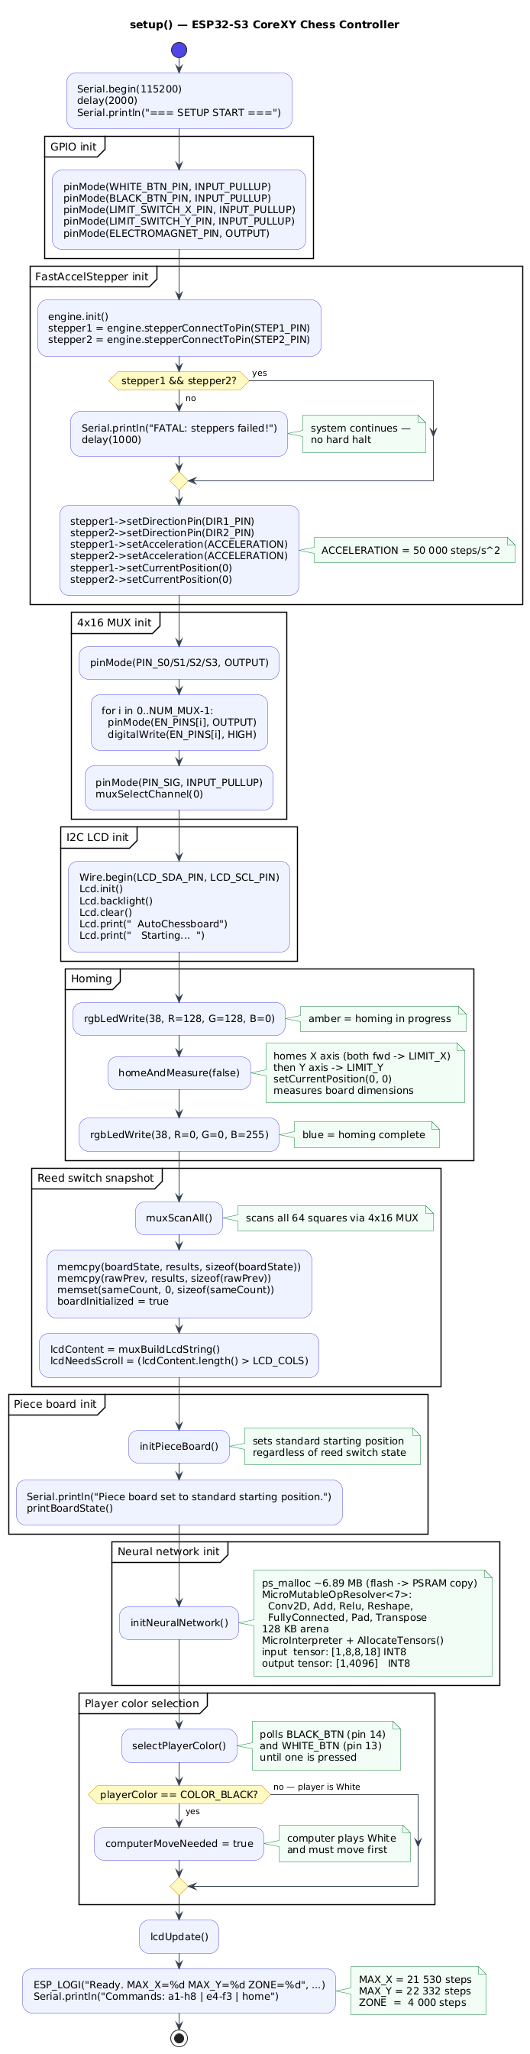
Flowcharts/setup().png
