TeaTimeIroh/AutomatedChessboard/docs/images/electronics_bench-test_20260330_040906.jpg

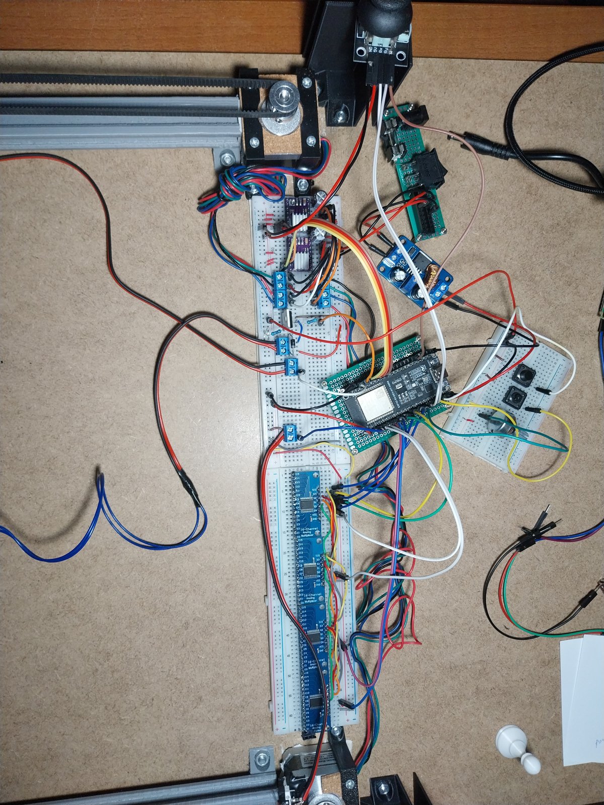
docs/images/electronics_bench-test_20260330_040906.jpg
