TeaTimeIroh/AutomatedChessboard/(commit log)

2026-05-11 Program Upload
    [Bishop.stl, BlockerForSwitch.stl]
2026-05-11 3d models
    [BoardHelper.stl, ButtonLarge.stl, King.stl, Knight.stl, LShapedCornerBeam.stl, LShapedCornerBeamForWalls_10cmWide.stl, LittleCircleExtension.stl, Pawn.stl]
2026-05-11 batch upload
    [partitions.csv]
2026-07-21 Neural Network Flowchart
2026-10-11 Reorganize repository into firmware/, ml/, cad/, electronics/ and docs/
    Pure renames, no content changes. The sketch now lives in a folder with the
    same name as the .ino so the Arduino IDE opens it directly. ML scripts are
    numbered in pipeline order; the abandoned ESP-DL attempt is kept under
    ml/experiments/.
2026-10-11 Rename photos by build phase and move them to docs/images
    Camera timestamps are kept at the end of each name so the build order is
    still visible; the prefix says what the photo shows.
2026-10-11 Add README, ML pipeline docs, requirements and .gitignore
    README covers the system, measured numbers, pin map, build settings and
    known limitations. ml/README documents the five pipeline stages and what
    the first training run actually did.
2026-10-11 Update README, firmware, ML requirements and add BOM with thesis
2026-10-12 Added build memory constraints and README compile button
