TeaTimeIroh/AutomatedChessboard/Images/20260319_215351.jpg

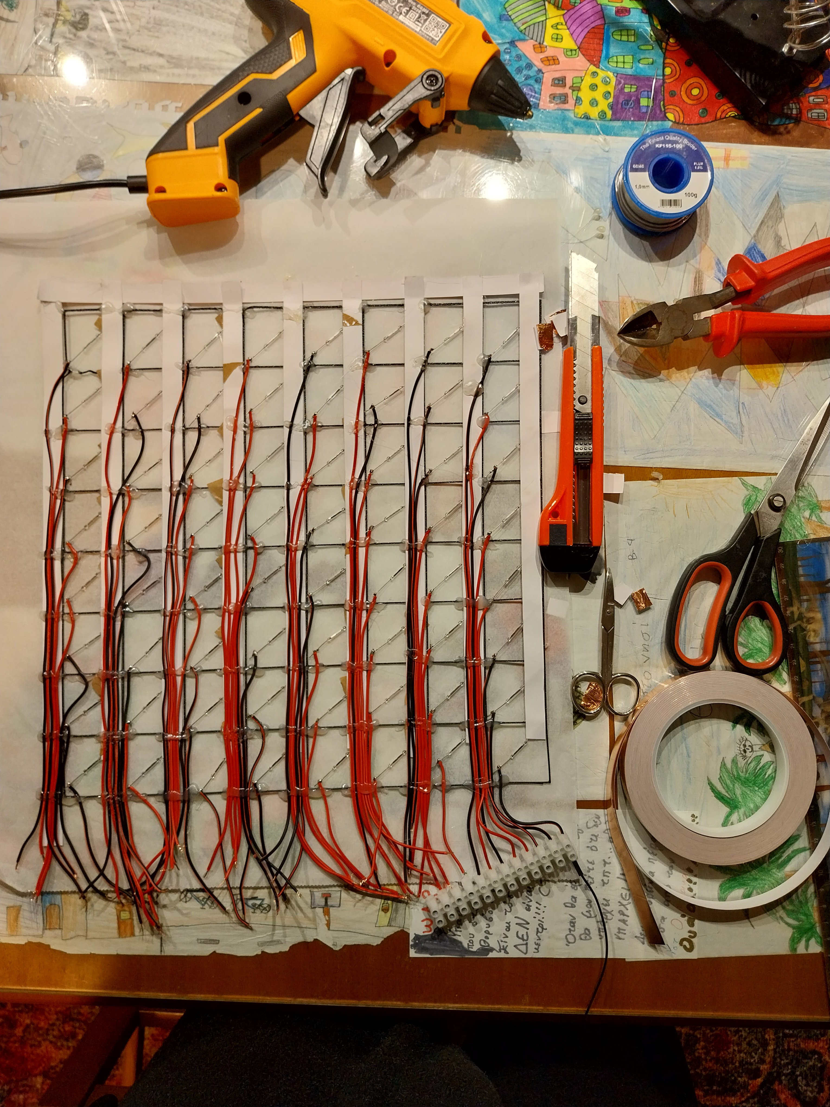
Images/20260319_215351.jpg
