TeaTimeIroh/AutomatedChessboard/Images/20260330_230000.jpg

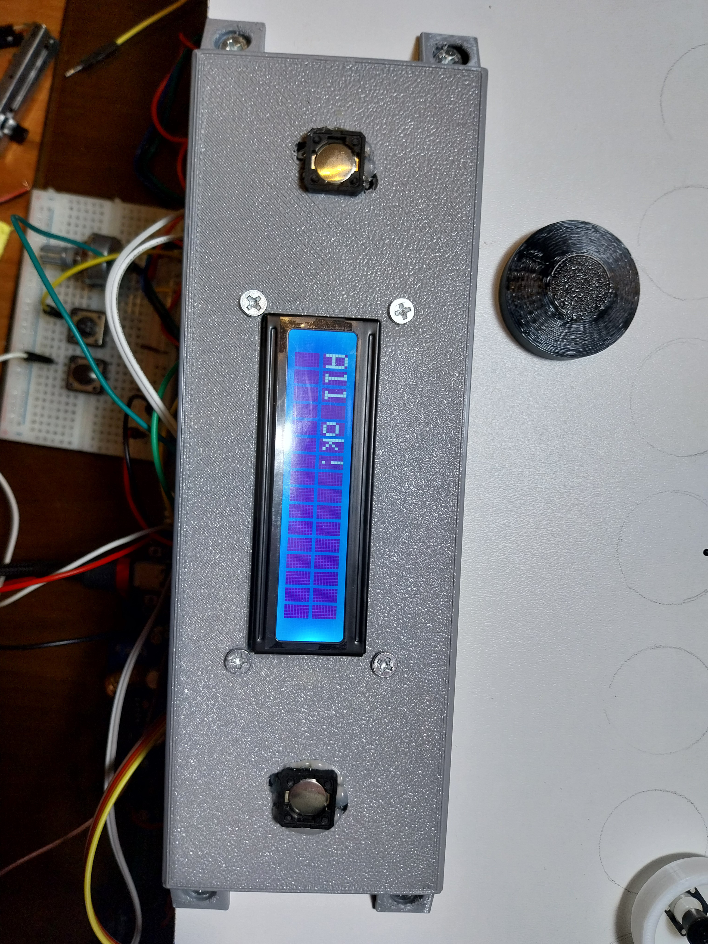
Images/20260330_230000.jpg
