TeaTimeIroh/AutomatedChessboard/Images/20260404_235405.jpg

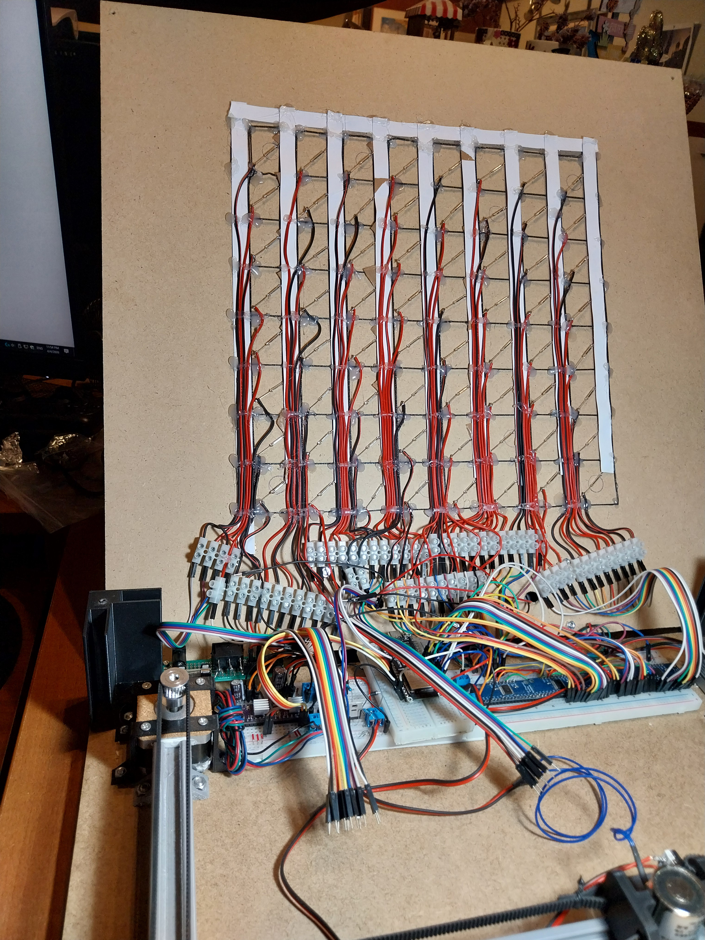
Images/20260404_235405.jpg
